LesKaribous/Karibous-2020/README.md

# Karibous-2020
Sources des projets robotique des Karibous pour l'année 2020
