LesKaribous/Karibous-2020/01 - CDRF/01 - ELECTRONIQUE/MAIN_BOARD V2/MAIN_BOARD_02_TOP.png

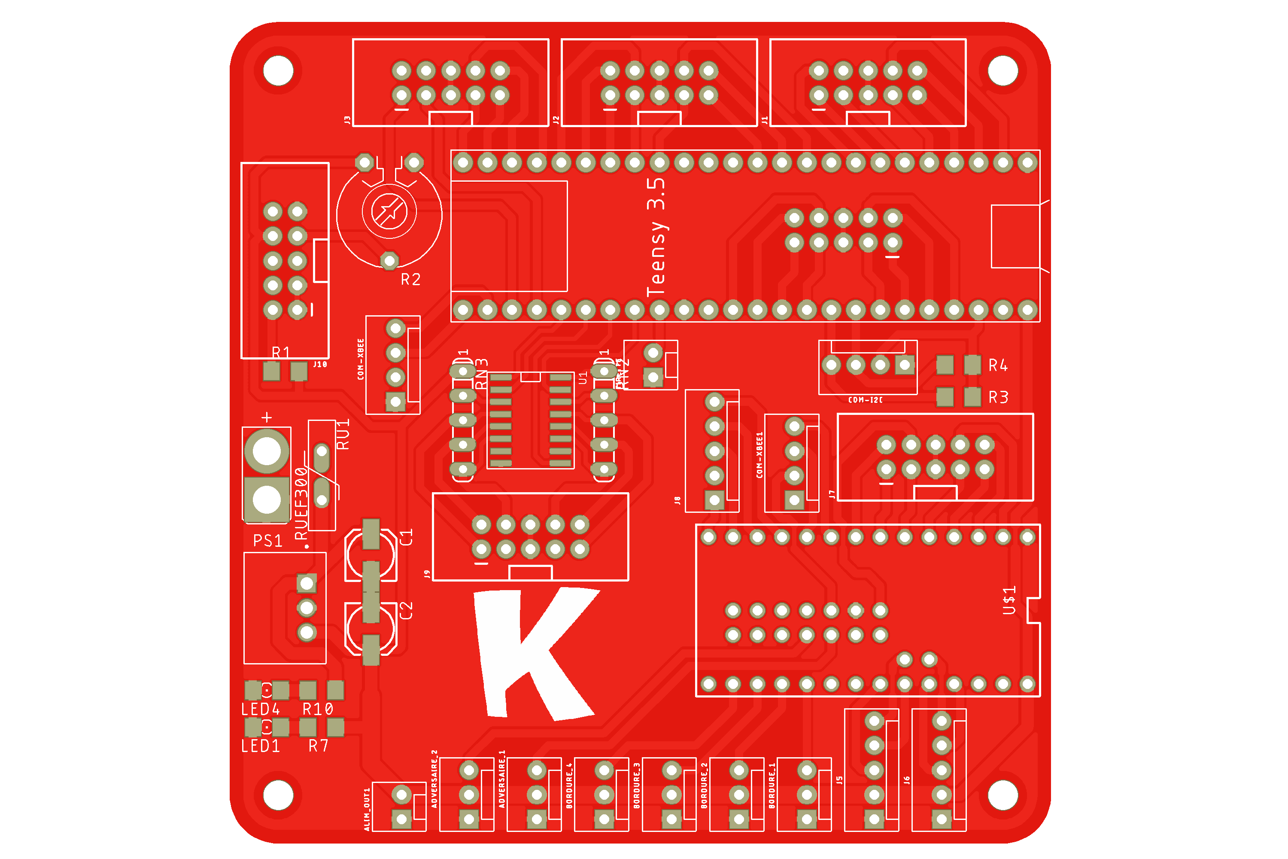
01 - CDRF/01 - ELECTRONIQUE/MAIN_BOARD V2/MAIN_BOARD_02_TOP.png
