LesKaribous/Karibous-2020/01 - CDRF/02 - MECANIQUE/01 - MAT BALISE/MAT BALISE Drawing.dxf

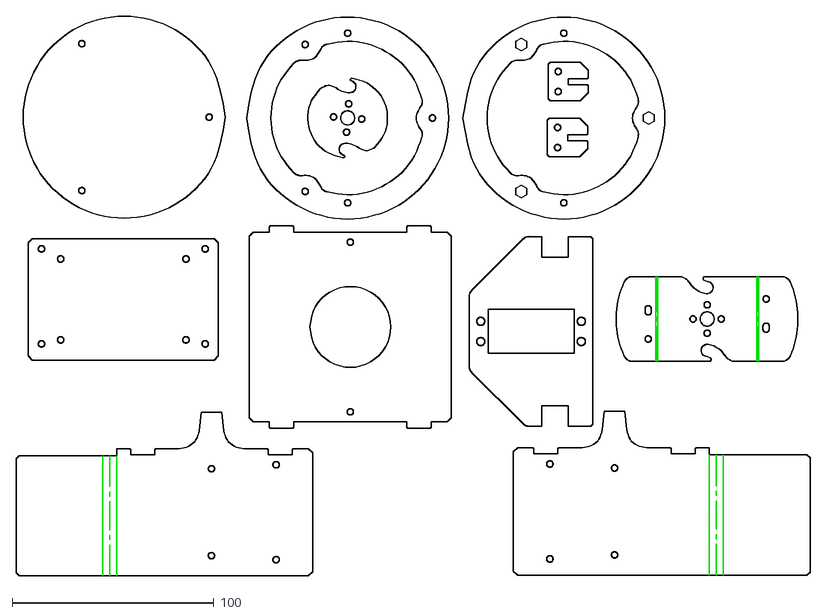
[picture p3: CAD file, 2019-10-25]
01 - CDRF/02 - MECANIQUE/01 - MAT BALISE/MAT BALISE Drawing.dxf
393.1 x 277.1
