LesKaribous/Karibous-2020/01 - CDRF/02 - MECANIQUE/02 - PNEUMATIQUE/MORS.stl

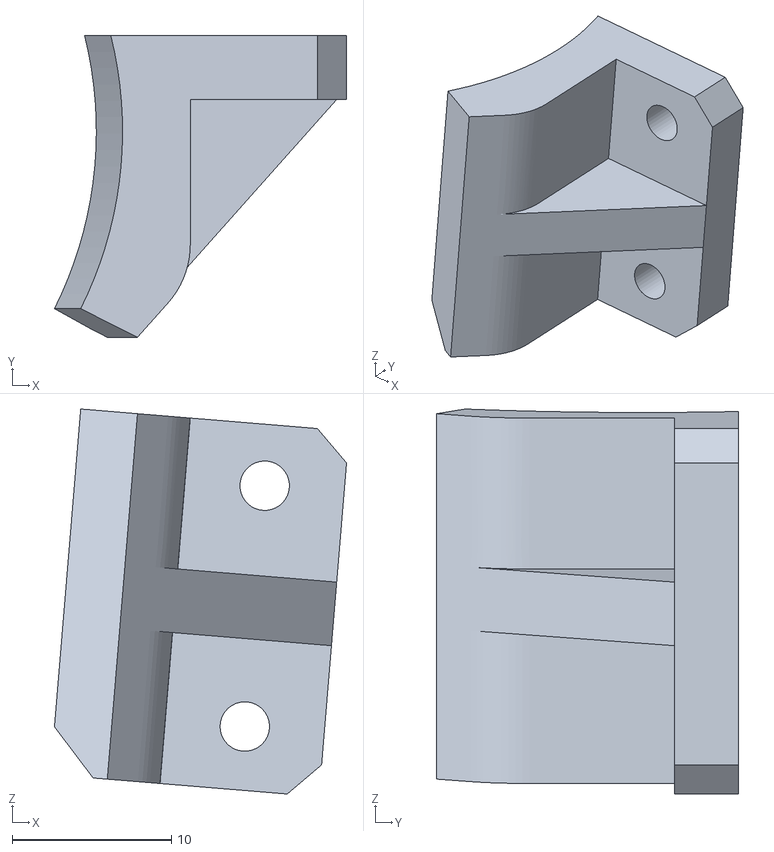
[picture p4: CAD file, 2020-03-07]
01 - CDRF/02 - MECANIQUE/02 - PNEUMATIQUE/MORS.stl
18.3 x 18.9 x 24.1
