LesKaribous/Karibous-2020/01 - CDRF/02 - MECANIQUE/01 - MAT BALISE/EQUERRE CARTER ELEC.stl

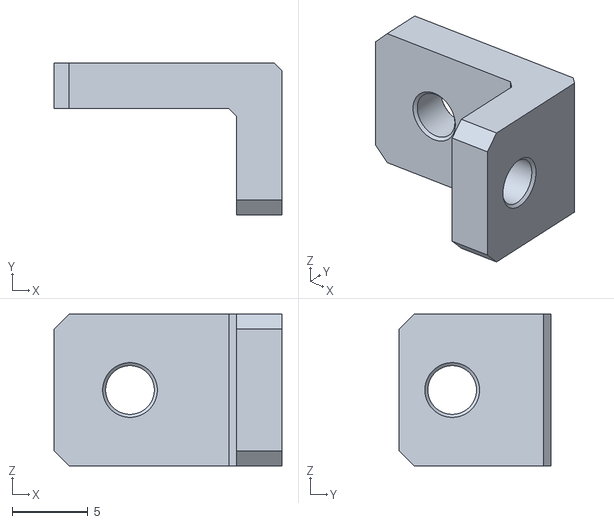
[picture p5: CAD file, 2019-10-25]
01 - CDRF/02 - MECANIQUE/01 - MAT BALISE/EQUERRE CARTER ELEC.stl
15.0 x 10.0 x 10.0
