LesKaribous/Karibous-2020/01 - CDRF/02 - MECANIQUE/02 - PNEUMATIQUE/MANCHONE_COUDE.stl

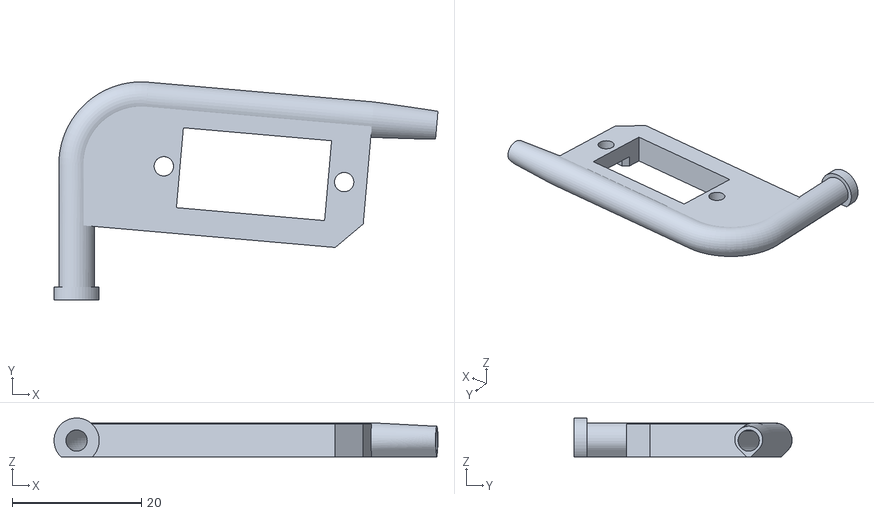
[picture p6: CAD file, 2020-03-07]
01 - CDRF/02 - MECANIQUE/02 - PNEUMATIQUE/MANCHONE_COUDE.stl
59.4 x 33.8 x 6.03
