LesKaribous/Karibous-2020/01 - CDRF/02 - MECANIQUE/02 - PNEUMATIQUE/CONNECTEUR_T.stl

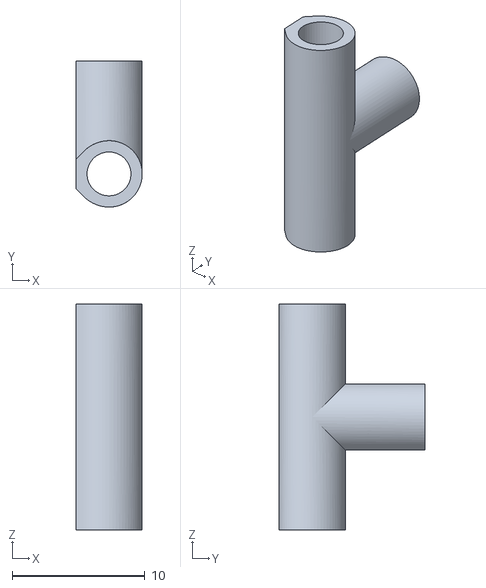
[picture p7: CAD file, 2020-01-31]
01 - CDRF/02 - MECANIQUE/02 - PNEUMATIQUE/CONNECTEUR_T.stl
5.00 x 11.0 x 17.0
