LesKaribous/Karibous-2020/01 - CDRF/02 - MECANIQUE/02 - PNEUMATIQUE/CLAMP.stl

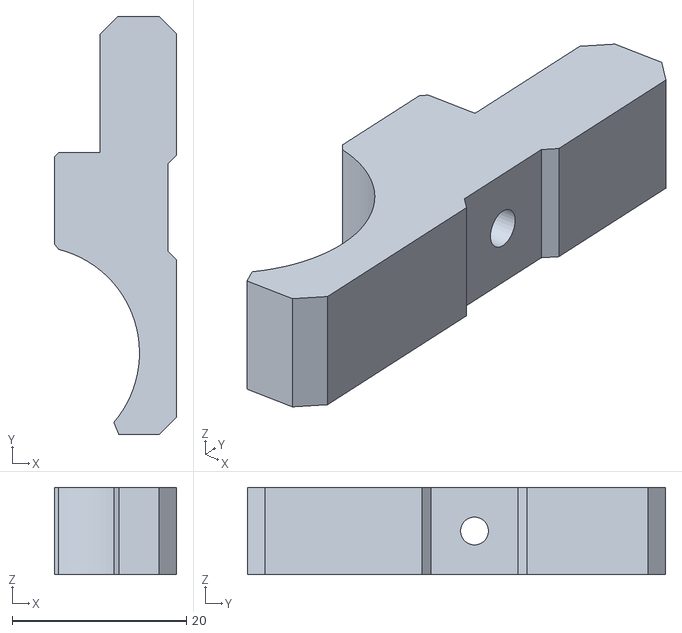
[picture p8: CAD file, 2020-01-31]
01 - CDRF/02 - MECANIQUE/02 - PNEUMATIQUE/CLAMP.stl
14.0 x 48.0 x 10.0
