LesKaribous/Karibous-2020/01 - CDRF/02 - MECANIQUE/01 - MAT BALISE/MAT BALISE Drawing.pdf

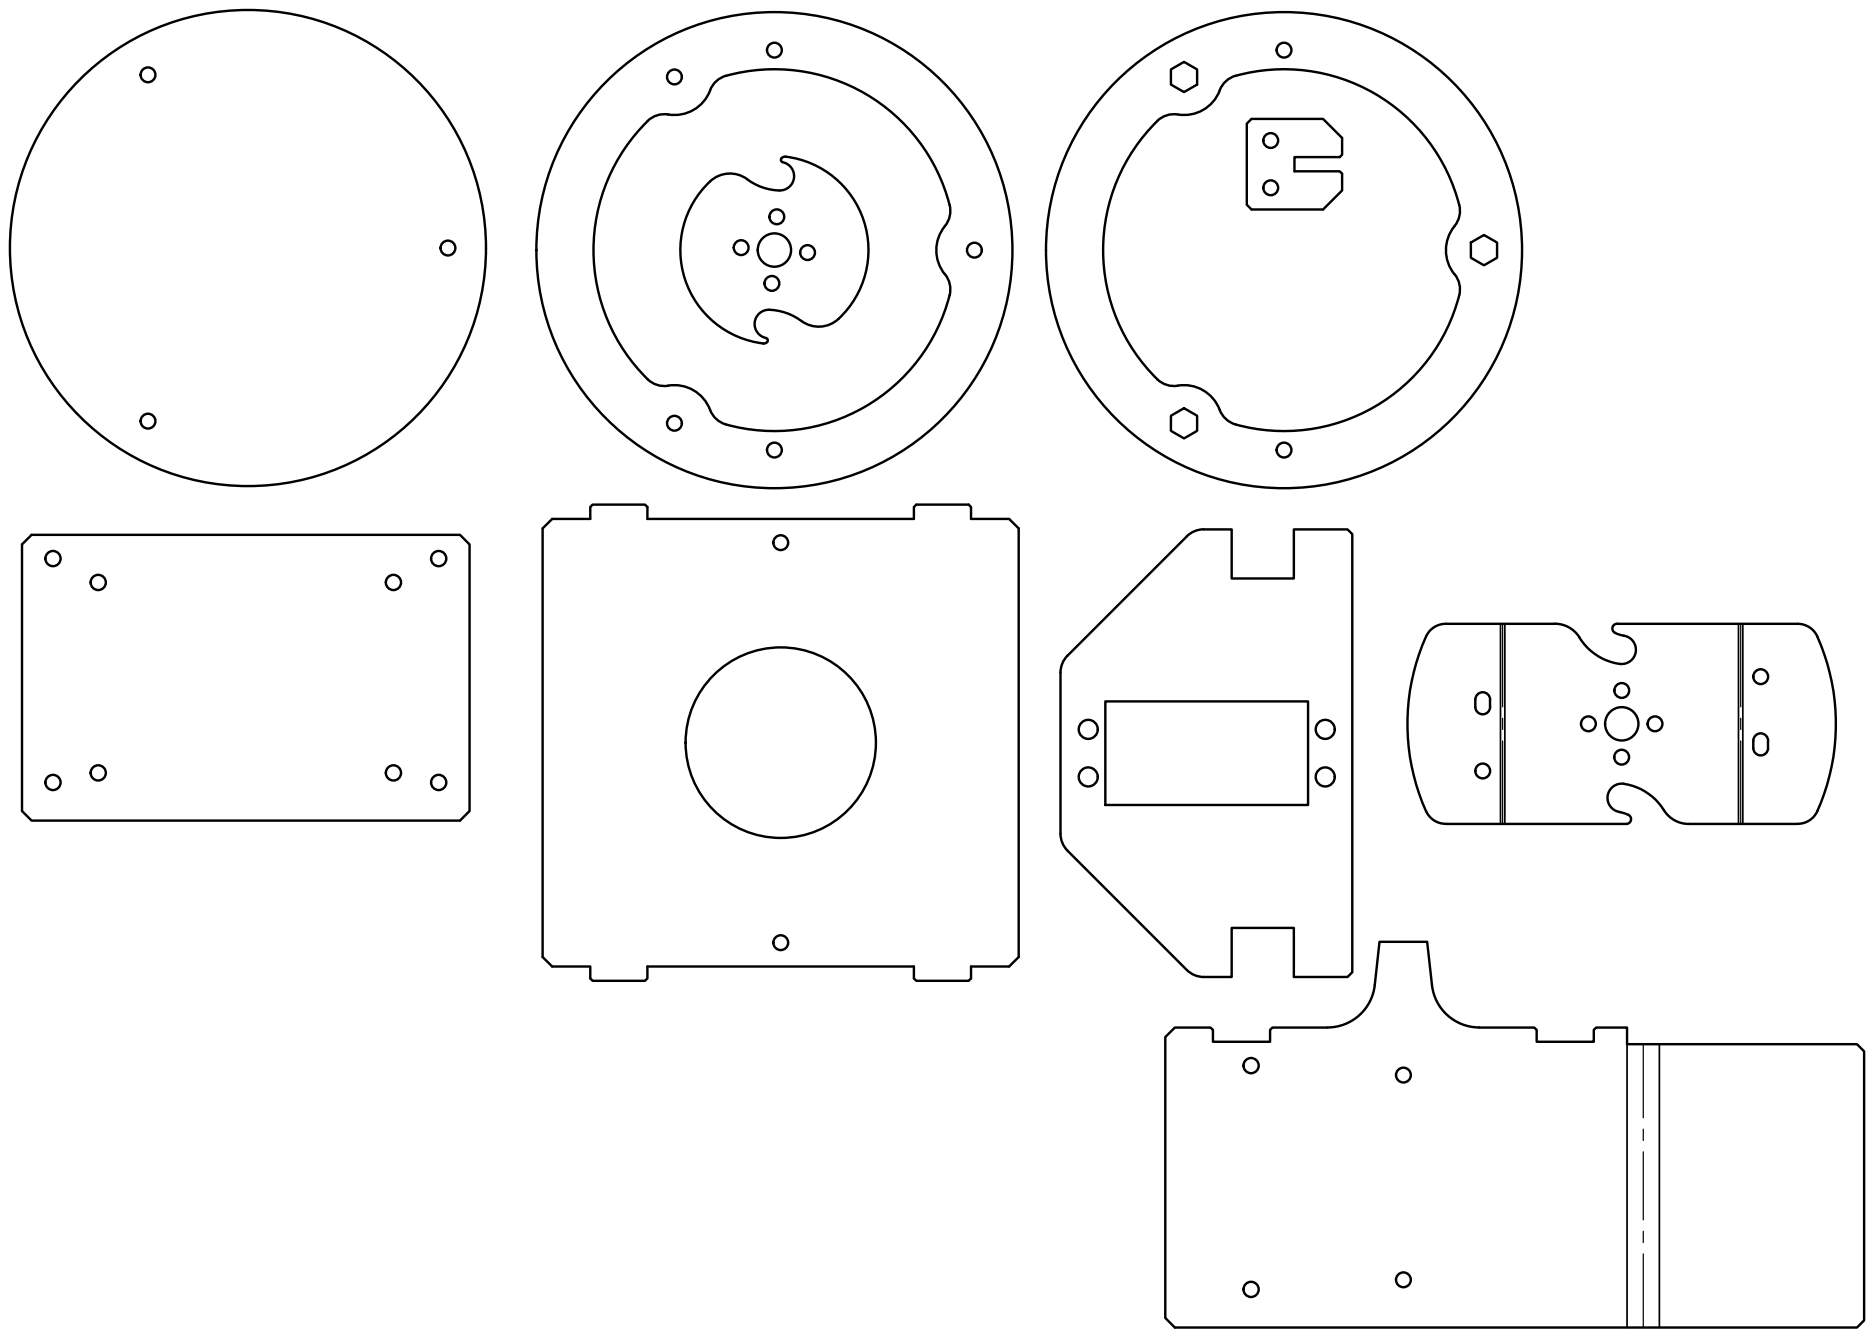
[picture p10: page 1]
