LesKaribous/Karibous-2020/01 - CDRF/01 - ELECTRONIQUE/ATTINY_SERVO_BOARD/ATTINY_SERVO_BOARD.brd

## EAGLE design 01 - CDRF/01 - ELECTRONIQUE/ATTINY_SERVO_BOARD/ATTINY_SERVO_BOARD.brd (2020-10-09)

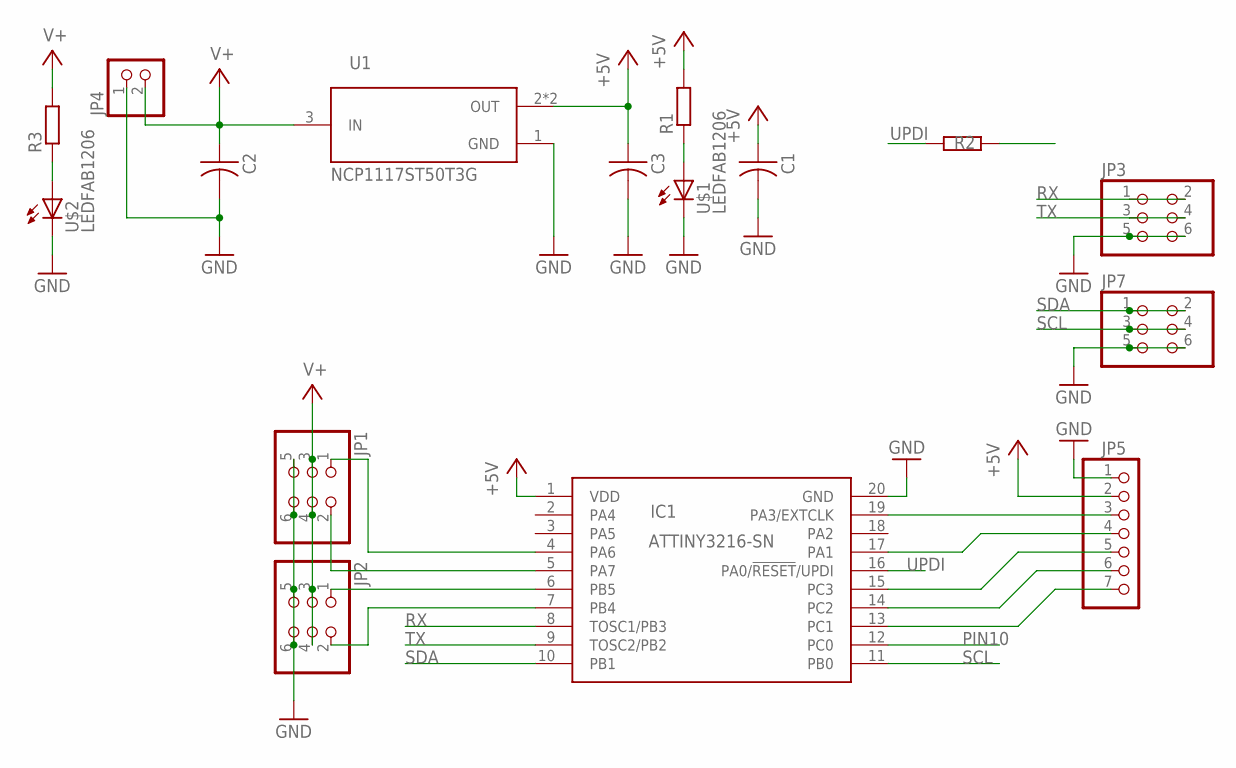
[picture p11: schematic ATTINY_SERVO_BOARD.sch]

Parts:
C1, C2, C3: CAP-US1206; C1206
IC1: ATTINY3216-SN; SOIC127P1030X265-20N
JP1, JP2, JP3, JP7: PINHD-2X03_2.54-SMD; 2X03SMD
JP4: PINHD-1X02_2.54-SMD-90°; 1X02SMD/90
JP5: PINHD-1X07_2.54-SMD-90°; 1X07SMD/90
R1, R2, R3: R-EU_R1206; R1206
U1: NCP1117ST50T3G; SOT230P700X180-4N
U$1, U$2: LEDFAB1206; LED1206FAB

Connections:
+5V: C1.1, C3.1, IC1.1 (VDD), JP5.2, R1.2, U1.2 (OUT), U1.4 (OUT)
GND: C1.2, C2.2, C3.2, IC1.20 (GND), JP1.5, JP1.6, JP2.5, JP2.6, JP3.5, JP3.6, JP4.1, JP5.1, JP7.5, JP7.6, U1.1 (GND), U$1.2 (C), U$2.2 (C)
unnamed: IC1.19 (PA3/EXTCLK), JP5.3
unnamed: R1.1, U$1.1 (A)
unnamed: IC1.7 (PB4), JP2.2
unnamed: IC1.6 (PB5), JP2.1
unnamed: IC1.5 (PA7), JP1.2
unnamed: IC1.4 (PA6), JP1.1
unnamed: R3.1, U$2.1 (A)
unnamed: IC1.17 (PA1), JP5.4
unnamed: IC1.15 (PC3), JP5.5
unnamed: IC1.14 (PC2), JP5.6
unnamed: IC1.13 (PC1), JP5.7
PIN10: IC1.12 (PC0)
RX: IC1.8 (TOSC1/PB3), JP3.1, JP3.2
SCL: IC1.11 (PB0), JP7.3, JP7.4
SDA: IC1.10 (PB1), JP7.1, JP7.2
TX: IC1.9 (TOSC2/PB2), JP3.3, JP3.4
UPDI: IC1.16 (PA0/!RESET!/UPDI), R2.2
V+: C2.1, JP1.3, JP1.4, JP2.3, JP2.4, JP4.2, R3.2, U1.3 (IN)

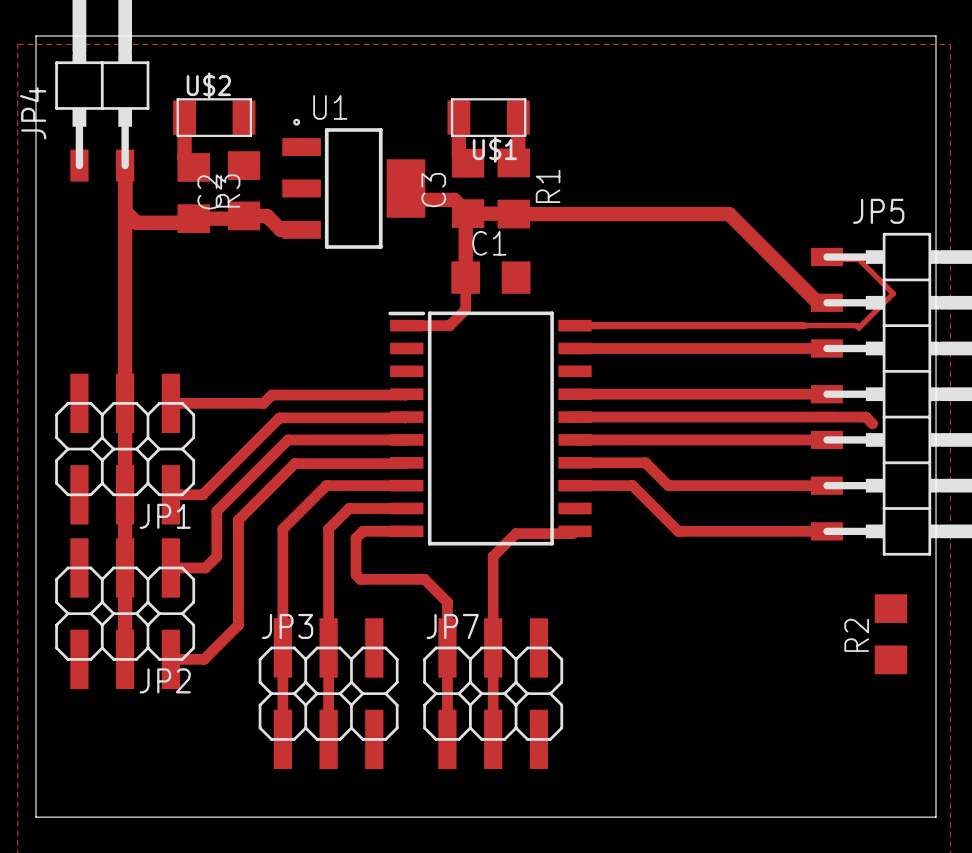
[picture p12: board ATTINY_SERVO_BOARD.brd from above]

Board: 2 copper layers, 50.0 x 43.4 mm, 16 parts (0 on the bottom side), 19 nets.
