LesKaribous/Karibous-2020/01 - CDRF/01 - ELECTRONIQUE/PCB_BALISE_328P/PCB_BALISE_328P.brd

## EAGLE design 01 - CDRF/01 - ELECTRONIQUE/PCB_BALISE_328P/PCB_BALISE_328P.brd (2020-06-26)

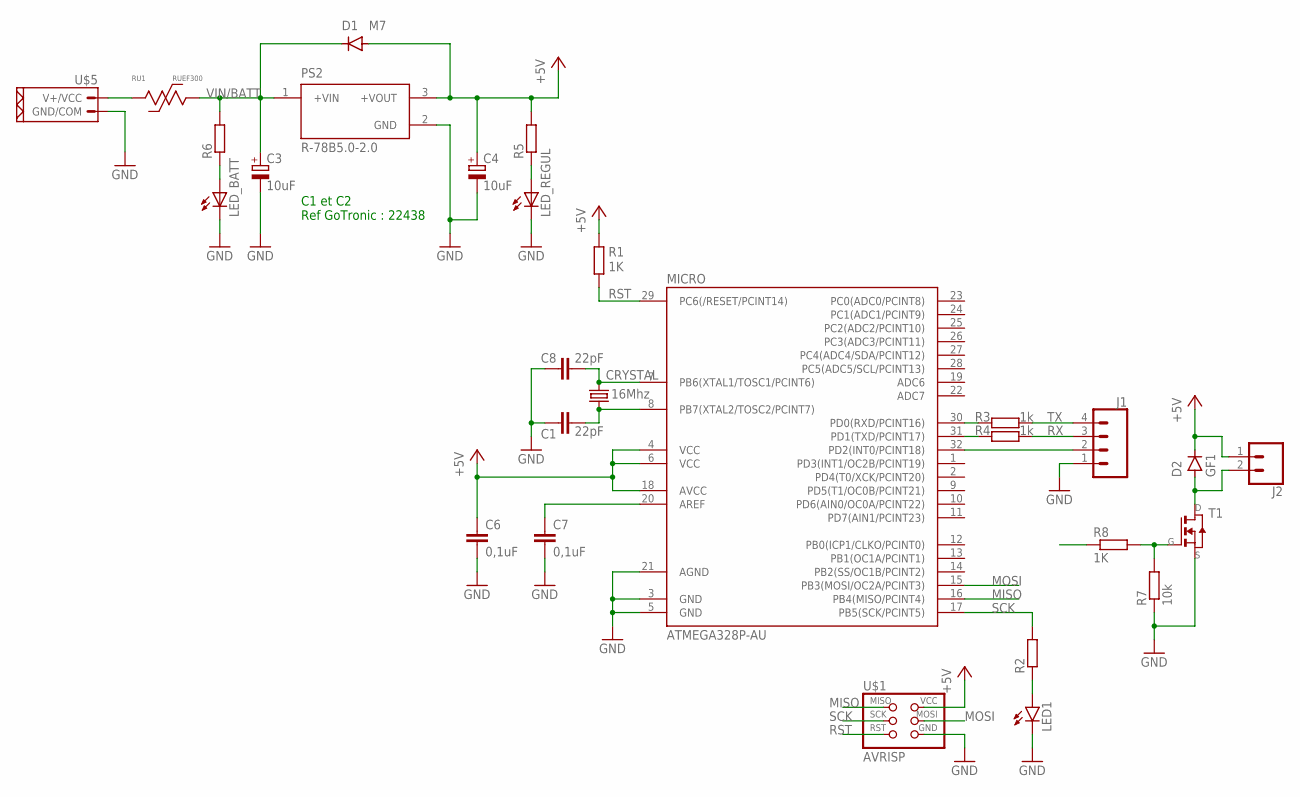
[picture p13: schematic PCB_BALISE_328P.sch]

Parts:
C1, C8: 22pF; C1206K
C3, C4: 10uF; 153CLV-0505
C6, C7: 0,1uF; C1206K
CRYSTAL: 16Mhz; CSM-7X-DU
D1: M7; MINI-SMA
D2: GF1; SMA-DO214AC
J1: CONN_04POLAR; MOLEX-1X4
J2: CONN_02POLAR; MOLEX-1X2
LED1: LEDSMT1206; 1206
LED_BATT: LED_E; LED_1206
LED_REGUL: LED_E; LED_1206
MICRO: ATMEGA328P-AU; TQFP32-08
PS2: R-78B5.0-2.0; CONV_R-78B5.0-2.0
R1, R8: 1K; R1206
R2, R5, R6: R-EU_R1206; R1206
R3, R4: 1k; R1206
R7: 10k; R1206
RU1: RUEF300
T1: NMOSFETSOT23; SOT-23
U$1: AVRISP; 2X03
U$5: CONN_02_PUIXT30; XT30_FEMALE

Connections:
+5V: C4.+, C6.1, D1.ANODE, D2.K (C), J2.1, MICRO.4 (VCC), MICRO.6 (VCC), MICRO.18 (AVCC), PS2.3 (+VOUT), R1.2, R5.2, U$1.2 (VCC)
GND: C1.1, C3.-, C4.-, C6.2, C7.2, C8.1, J1.1, LED1.C, LED_BATT.C, LED_REGUL.C, MICRO.3 (GND), MICRO.5 (GND), MICRO.21 (AGND), PS2.2 (GND), R7.1, T1.2 (S), U$1.6 (GND), U$5.P$2 (GND/COM)
MISO: MICRO.16 (PB4(MISO/PCINT4)), U$1.1 (MISO)
MOSI: MICRO.15 (PB3(MOSI/OC2A/PCINT3)), U$1.4 (MOSI)
unnamed: C7.1, MICRO.20 (AREF)
unnamed: C8.2, CRYSTAL.2, MICRO.7 (PB6(XTAL1/TOSC1/PCINT6))
unnamed: LED1.A, R2.1
unnamed: MICRO.30 (PD0(RXD/PCINT16)), R3.2
unnamed: MICRO.31 (PD1(TXD/PCINT17)), R4.2
unnamed: J1.2, MICRO.32 (PD2(INT0/PCINT18))
unnamed: LED_BATT.A, R6.1
unnamed: RU1.P$1, U$5.P$1 (V+/VCC)
unnamed: C1.2, CRYSTAL.1, MICRO.8 (PB7(XTAL2/TOSC2/PCINT7))
unnamed: LED_REGUL.A, R5.1
unnamed: D2.A, J2.2, T1.1 (D)
unnamed: R7.2, R8.2, T1.3 (G)
PUMP: R8.1
RST: MICRO.29 (PC6(/RESET/PCINT14)), R1.1, U$1.5 (RST)
RX: J1.3, R4.1
SCK: MICRO.17 (PB5(SCK/PCINT5)), R2.2, U$1.3 (SCK)
TX: J1.4, R3.1
VIN/BATT: C3.+, D1.KATHODE, PS2.1 (+VIN), R6.2, RU1.P$2

Notes on the sheet:
C1 et C2 Ref GoTronic : 22438

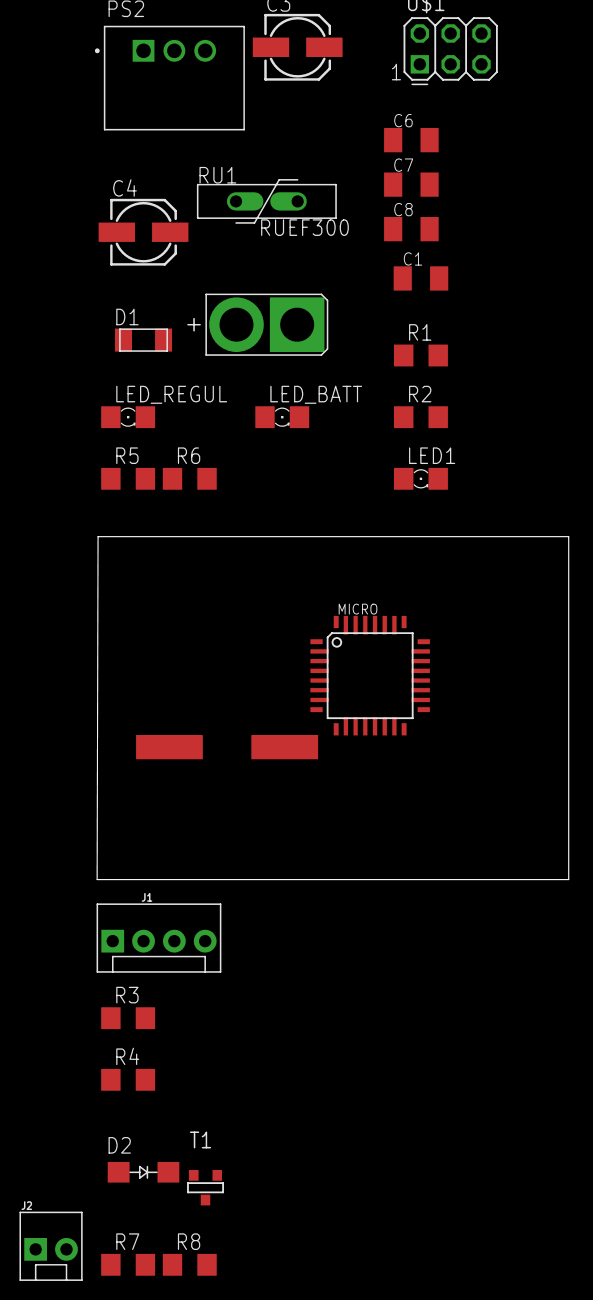
[picture p14: board PCB_BALISE_328P.brd from above]

Board: 2 copper layers, 38.9 x 28.3 mm, 28 parts (0 on the bottom side), 21 nets.
