LesKaribous/Karibous-2020/01 - CDRF/01 - ELECTRONIQUE/CAPTEUR_HALL_V2/AdaptSensor.brd

## EAGLE design 01 - CDRF/01 - ELECTRONIQUE/CAPTEUR_HALL_V2/AdaptSensor.brd (2020-06-22)

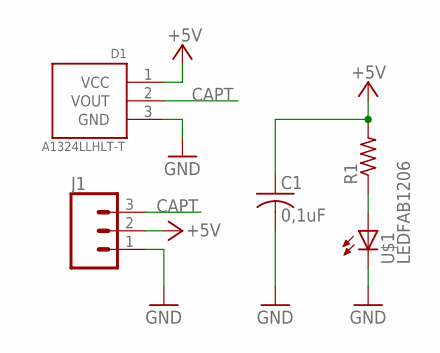
[picture p15: schematic AdaptSensor.sch]

Parts:
C1: 0,1uF; C1206FAB
D1: A1324LLHLT-T; SOT190P290X100-3N
J1: CONN_03POLAR; MOLEX-1X3
R1: RES-US1206FAB; R1206FAB
U$1: LEDFAB1206; LED1206FAB

Connections:
+5V: C1.1, D1.1 (VCC), J1.2, R1.2
CAPT: D1.2 (VOUT), J1.3
GND: C1.2, D1.3 (GND), J1.1, U$1.2 (C)
unnamed: R1.1, U$1.1 (A)

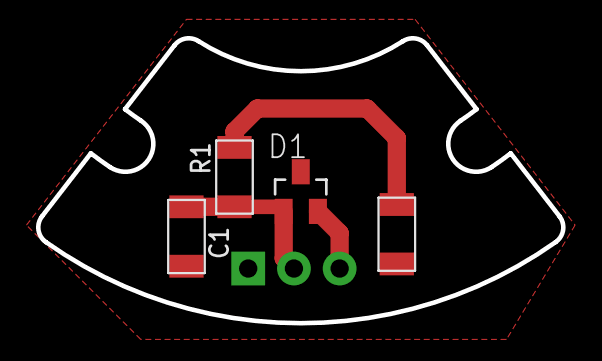
[picture p16: board AdaptSensor.brd from above]

Board: 2 copper layers, 29.2 x 15.8 mm, 5 parts (1 on the bottom side), 4 nets.
