LesKaribous/Karibous-2020/01 - CDRF/01 - ELECTRONIQUE/PCB_MOTEUR V2/PCB_MOTEUR_V0_2b.brd

## EAGLE design 01 - CDRF/01 - ELECTRONIQUE/PCB_MOTEUR V2/PCB_MOTEUR_V0_2b.brd (2020-05-23)

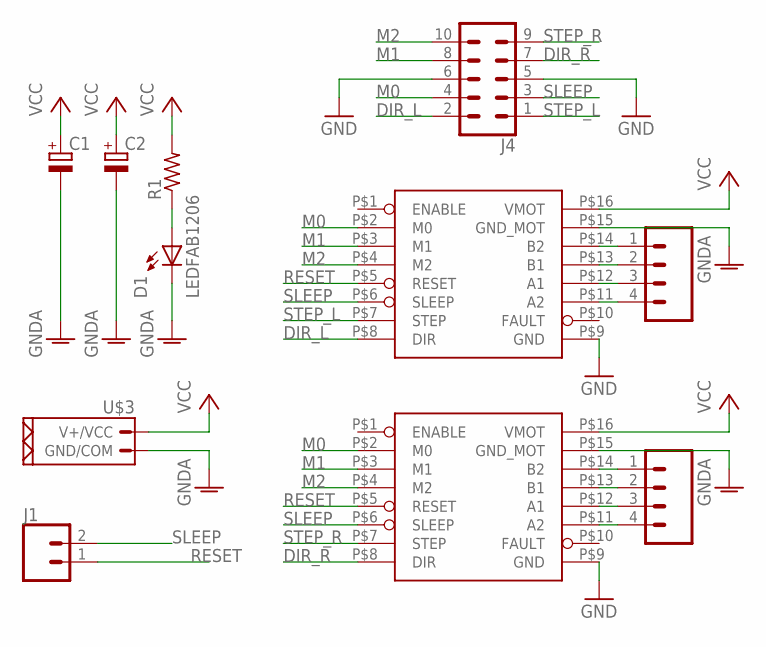
[picture p17: schematic PCB_MOTEUR_V0_2b.sch]

Parts:
C1, C2: CPOL-EUE3.5-8; E3,5-8
D1: LEDFAB1206; LED1206FAB
J1: CONN_02; 1X02
J3, J5: CONN_04POLAR; MOLEX-1X4
J4: CONN_05X2SHD; 2X5-SHROUDED
R1: RES-US1206FAB; R1206FAB
U$1, U$2: DRV8825; DRIVER_CARRIER_POLOLU_16
U$3: CONN_02_PUIXT30; XT30_FEMALE

Connections:
DIR_L: J4.2, U$1.P$8 (DIR)
DIR_R: J4.7, U$2.P$8 (DIR)
GND: J4.5, J4.6, U$1.P$9 (GND), U$2.P$9 (GND)
GNDA: C1.-, C2.-, D1.2 (C), U$1.P$15 (GND_MOT), U$2.P$15 (GND_MOT), U$3.P$2 (GND/COM)
M0: J4.4, U$1.P$2 (M0), U$2.P$2 (M0)
M1: J4.8, U$1.P$3 (M1), U$2.P$3 (M1)
M2: J4.10, U$1.P$4 (M2), U$2.P$4 (M2)
unnamed: J3.1, U$1.P$14 (B2)
unnamed: J3.2, U$1.P$13 (B1)
unnamed: J3.3, U$1.P$12 (A1)
unnamed: J3.4, U$1.P$11 (A2)
unnamed: D1.1 (A), R1.1
unnamed: J5.1, U$2.P$14 (B2)
unnamed: J5.2, U$2.P$13 (B1)
unnamed: J5.3, U$2.P$12 (A1)
unnamed: J5.4, U$2.P$11 (A2)
RESET: J1.1, U$1.P$5 (RESET), U$2.P$5 (RESET)
SLEEP: J1.2, J4.3, U$1.P$6 (SLEEP), U$2.P$6 (SLEEP)
STEP_L: J4.1, U$1.P$7 (STEP)
STEP_R: J4.9, U$2.P$7 (STEP)
VCC: C1.+, C2.+, R1.2, U$1.P$16 (VMOT), U$2.P$16 (VMOT), U$3.P$1 (V+/VCC)

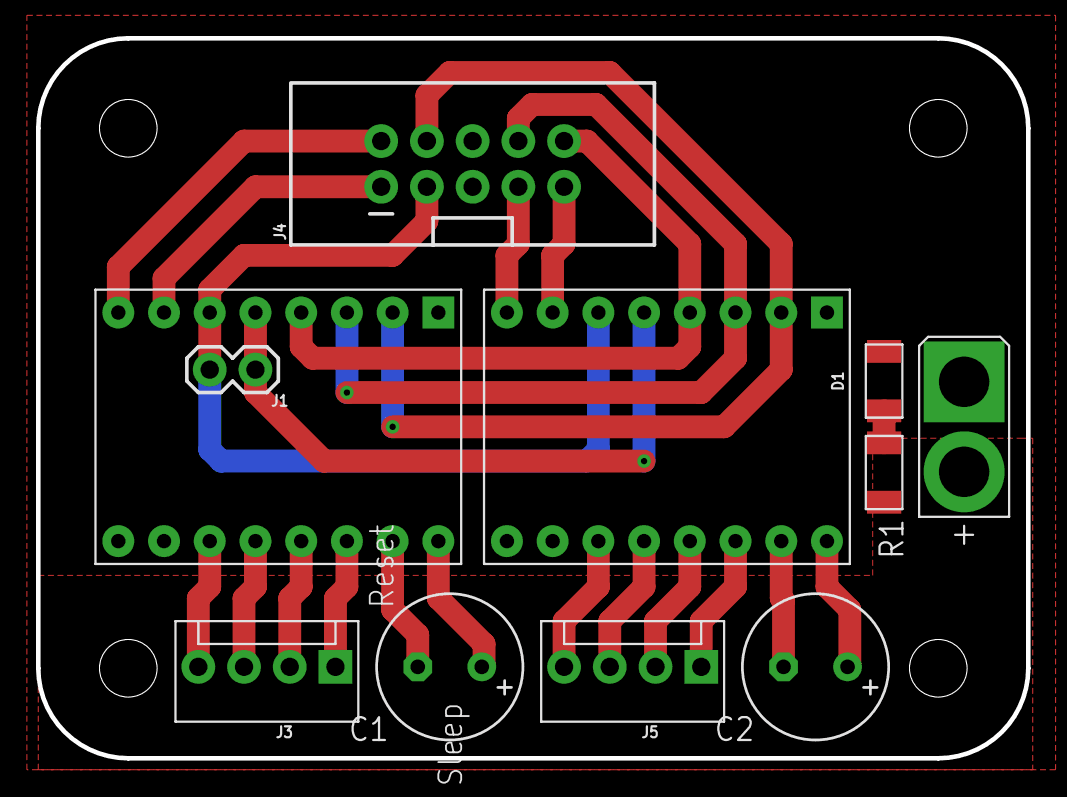
[picture p18: board PCB_MOTEUR_V0_2b.brd from above]

Board: 2 copper layers, 55.0 x 40.0 mm, 11 parts (0 on the bottom side), 21 nets.
