LesKaribous/Karibous-2020/01 - CDRF/01 - ELECTRONIQUE/MAIN_BOARD V2/MAIN_BOARD_02.brd

## EAGLE design 01 - CDRF/01 - ELECTRONIQUE/MAIN_BOARD V2/MAIN_BOARD_02.brd (2020-05-23)

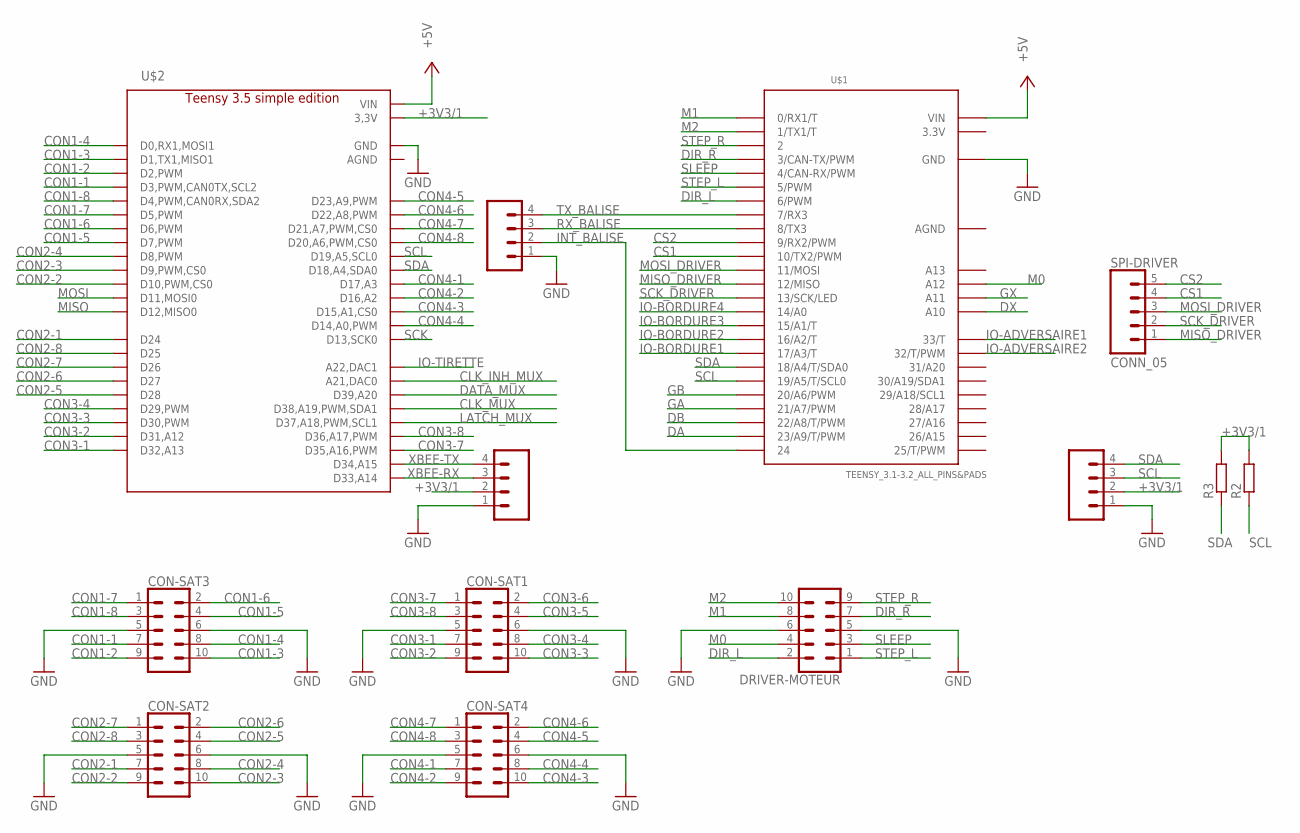
[picture p19: schematic MAIN_BOARD_02.sch, sheet 1]

Parts:
COM-BALISE: CONN_04POLAR; MOLEX-1X4
COM-I2C: CONN_04POLAR; MOLEX-1X4
COM-XBEE: CONN_04POLAR; MOLEX-1X4
CON-SAT1, CON-SAT2, CON-SAT3, CON-SAT4: CONN_05X2SHD; 2X5-SHROUDED
DRIVER-MOTEUR: CONN_05X2SHD; 2X5-SHROUDED
R2, R3: R-EU_R1206; R1206
SPI-DRIVER: CONN_05; MOLEX-1X5
U$1: TEENSY_3.1-3.2_ALL_PINS&PADS; TEENSY_3.0-3.2_ALL_PINS_&_PADS
U$2: TEENSY_3.5; TEENSY_3.5_LIGHT

Connections:
3.3V: U$1.3.3V, U$1.3.3V2 (3.3V)
+3V3/1: COM-I2C.2, COM-XBEE.2, R2.2, R3.2, U$2.P$15 (3,3V), U$2.P$46 (3,3V)
+5V: U$1.VIN, U$2.P$48 (VIN); also elsewhere on the board
AGND: U$1.AGND
CLK_INH_MUX: U$2.P$32 (A21,DAC0); also elsewhere on the board
CLK_MUX: U$2.P$30 (D38,A19,PWM,SDA1); also elsewhere on the board
CON1-1: CON-SAT3.7, U$2.P$5 (D3,PWM,CAN0TX,SCL2)
CON1-2: CON-SAT3.9, U$2.P$4 (D2,PWM)
CON1-3: CON-SAT3.10, U$2.P$3 (D1,TX1,MISO1)
CON1-4: CON-SAT3.8, U$2.P$2 (D0,RX1,MOSI1)
CON1-5: CON-SAT3.4, U$2.P$9 (D7,PWM)
CON1-6: CON-SAT3.2, U$2.P$8 (D6,PWM)
CON1-7: CON-SAT3.1, U$2.P$7 (D5,PWM)
CON1-8: CON-SAT3.3, U$2.P$6 (D4,PWM,CAN0RX,SDA2)
CON2-1: CON-SAT2.7, U$2.P$16 (D24)
CON2-2: CON-SAT2.9, U$2.P$12 (D10,PWM,CS0)
CON2-3: CON-SAT2.10, U$2.P$11 (D9,PWM,CS0)
CON2-4: CON-SAT2.8, U$2.P$10 (D8,PWM)
CON2-5: CON-SAT2.4, U$2.P$20 (D28)
CON2-6: CON-SAT2.2, U$2.P$19 (D27)
CON2-7: CON-SAT2.1, U$2.P$18 (D26)
CON2-8: CON-SAT2.3, U$2.P$17 (D25)
CON3-1: CON-SAT1.7, U$2.P$24 (D32,A13)
CON3-2: CON-SAT1.9, U$2.P$23 (D31,A12)
CON3-3: CON-SAT1.10, U$2.P$22 (D30,PWM)
CON3-4: CON-SAT1.8, U$2.P$21 (D29,PWM)
CON3-5: CON-SAT1.4
CON3-6: CON-SAT1.2
CON3-7: CON-SAT1.1, U$2.P$27 (D35,A16,PWM)
CON3-8: CON-SAT1.3, U$2.P$28 (D36,A17,PWM)
CON4-1: CON-SAT4.7, U$2.P$39 (D17,A3)
CON4-2: CON-SAT4.9, U$2.P$38 (D16,A2)
CON4-3: CON-SAT4.10, U$2.P$37 (D15,A1,CS0)
CON4-4: CON-SAT4.8, U$2.P$36 (D14,A0,PWM)
CON4-5: CON-SAT4.4, U$2.P$45 (D23,A9,PWM)
CON4-6: CON-SAT4.2, U$2.P$44 (D22,A8,PWM)
CON4-7: CON-SAT4.1, U$2.P$43 (D21,A7,PWM,CS0)
CON4-8: CON-SAT4.3, U$2.P$42 (D20,A6,PWM,CS0)
CS1: SPI-DRIVER.4, U$1.10 (10/TX2/PWM)
CS2: SPI-DRIVER.5, U$1.9 (9/RX2/PWM)
DA: U$1.23/A9 (23/A9/T/PWM); also elsewhere on the board
DATA_MUX: U$2.P$31 (D39,A20); also elsewhere on the board
DB: U$1.22/A8 (22/A8/T/PWM); also elsewhere on the board
DIR_L: DRIVER-MOTEUR.2, U$1.6 (6/PWM)
DIR_R: DRIVER-MOTEUR.7, U$1.3 (3/CAN-TX/PWM)
DX: U$1.A10; also elsewhere on the board
GA: U$1.21/A7 (21/A7/PWM); also elsewhere on the board
GB: U$1.20/A6 (20/A6/PWM); also elsewhere on the board
GND: COM-BALISE.1, COM-I2C.1, COM-XBEE.1, CON-SAT1.5, CON-SAT1.6, CON-SAT2.5, CON-SAT2.6, CON-SAT3.5, CON-SAT3.6, CON-SAT4.5, CON-SAT4.6, DRIVER-MOTEUR.5, DRIVER-MOTEUR.6, U$1.GND, U$1.GND2 (GND), U$2.GND, U$2.P$34 (GND); also elsewhere on the board
GX: U$1.A11; also elsewhere on the board
INT_BALISE: COM-BALISE.2, U$1.24
IO-ADVERSAIRE1: U$1.33 (33/T); also elsewhere on the board
IO-ADVERSAIRE2: U$1.32 (32/T/PWM); also elsewhere on the board
IO-BORDURE1: U$1.17/A3 (17/A3/T); also elsewhere on the board
IO-BORDURE2: U$1.16/A2 (16/A2/T); also elsewhere on the board
IO-BORDURE3: U$1.15/A1 (15/A1/T); also elsewhere on the board
IO-BORDURE4: U$1.14/A0; also elsewhere on the board
IO-TIRETTE: U$2.P$33 (A22,DAC1); also elsewhere on the board
LATCH_MUX: U$2.P$29 (D37,A18,PWM,SCL1); also elsewhere on the board
M0: DRIVER-MOTEUR.4, U$1.A12
M1: DRIVER-MOTEUR.8, U$1.0 (0/RX1/T)
M2: DRIVER-MOTEUR.10, U$1.1 (1/TX1/T)
MISO: U$2.P$14 (D12,MISO0); also elsewhere on the board
MISO_DRIVER: SPI-DRIVER.1, U$1.12 (12/MISO)
MOSI: U$2.P$13 (D11,MOSI0); also elsewhere on the board
MOSI_DRIVER: SPI-DRIVER.3, U$1.11 (11/MOSI)
RX_BALISE: COM-BALISE.3, U$1.8 (8/TX3)
SCK: U$2.P$35 (D13,SCK0); also elsewhere on the board
SCK_DRIVER: SPI-DRIVER.2, U$1.13 (13/SCK/LED)
SCL: COM-I2C.3, R2.1, U$1.19/A5 (19/A5/T/SCL0), U$2.P$41 (D19,A5,SCL0)
SDA: COM-I2C.4, R3.1, U$1.18/A4 (18/A4/T/SDA0), U$2.P$40 (D18,A4,SDA0)
SLEEP: DRIVER-MOTEUR.3, U$1.4 (4/CAN-RX/PWM)
STEP_L: DRIVER-MOTEUR.1, U$1.5 (5/PWM)
STEP_R: DRIVER-MOTEUR.9, U$1.2
TX_BALISE: COM-BALISE.4, U$1.7 (7/RX3)
XBEE-RX: COM-XBEE.3, U$2.P$25 (D33,A14)
XBEE-TX: COM-XBEE.4, U$2.P$26 (D34,A15)

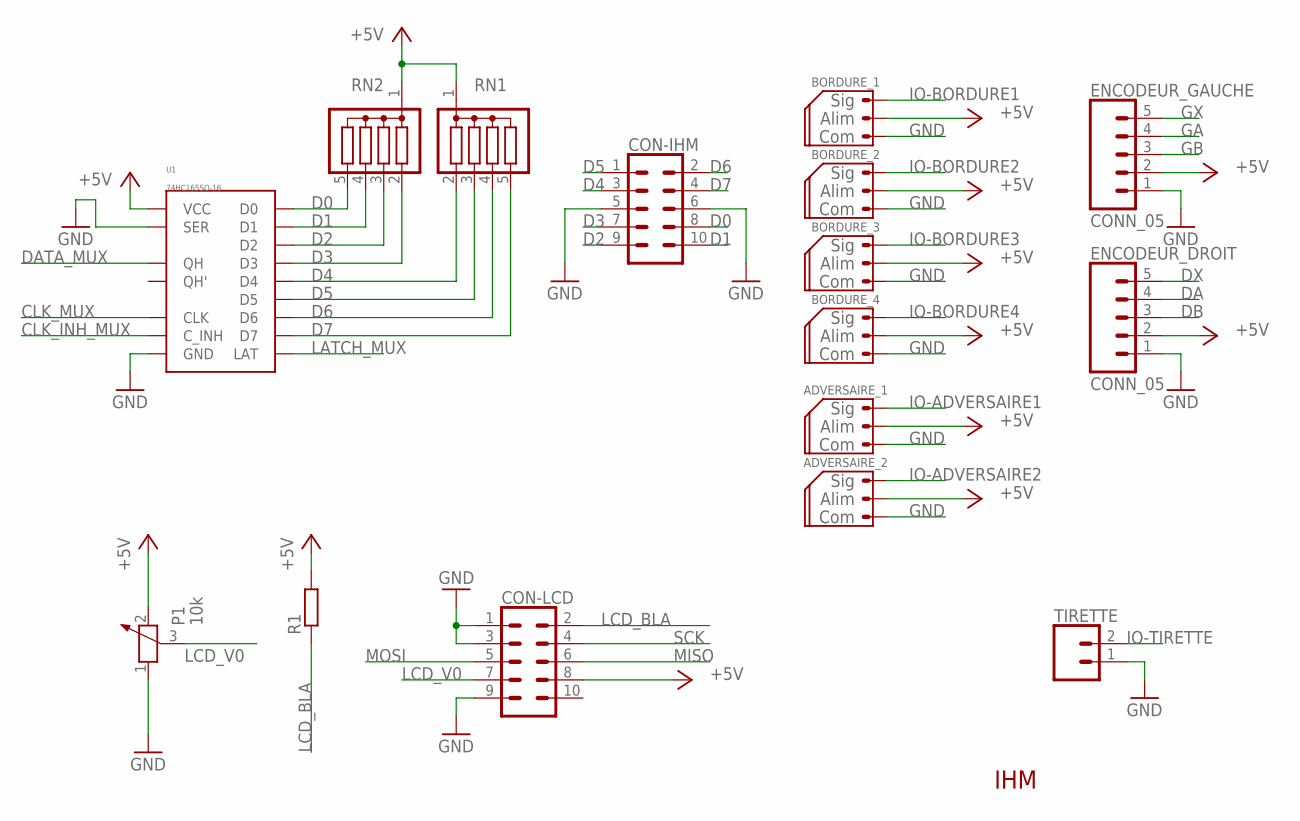
[picture p20: schematic MAIN_BOARD_02.sch, sheet 2]

Parts:
ADVERSAIRE_1, ADVERSAIRE_2: CONN_03_SERVO; MOLEX-1X3
BORDURE_1, BORDURE_2, BORDURE_3, BORDURE_4: CONN_03_SERVO; MOLEX-1X3
CON-IHM: CONN_05X2SHD; 2X5-SHROUDED
CON-LCD: CONN_05X2SHD; 2X5-SHROUDED
ENCODEUR_DROIT: CONN_05; MOLEX-1X5
ENCODEUR_GAUCHE: CONN_05; MOLEX-1X5
P1: 10k; PT-10
R1: R-EU_R1206; R1206
RN1, RN2: G04R; SIL5
TIRETTE: CONN_02POLAR; MOLEX-1X2
U1: 74HC165SO-16; SO-16
U$3: LOGO_K; LOGO_KARIBOU

Connections:
+5V: ADVERSAIRE_1.2, ADVERSAIRE_2.2, BORDURE_1.2, BORDURE_2.2, BORDURE_3.2, BORDURE_4.2, CON-LCD.8, ENCODEUR_DROIT.2, ENCODEUR_GAUCHE.2, P1.2, R1.2, RN1.1, RN2.1, U1.16 (VCC); also elsewhere on the board
CLK_INH_MUX: U1.15 (C_INH); also elsewhere on the board
CLK_MUX: U1.2 (CLK); also elsewhere on the board
D0: CON-IHM.8, RN2.5, U1.11 (D0)
D1: CON-IHM.10, RN2.4, U1.12 (D1)
D2: CON-IHM.9, RN2.3, U1.13 (D2)
D3: CON-IHM.7, RN2.2, U1.14 (D3)
D4: CON-IHM.3, RN1.2, U1.3 (D4)
D5: CON-IHM.1, RN1.3, U1.4 (D5)
D6: CON-IHM.2, RN1.4, U1.5 (D6)
D7: CON-IHM.4, RN1.5, U1.6 (D7)
DA: ENCODEUR_DROIT.4; also elsewhere on the board
DATA_MUX: U1.9 (QH); also elsewhere on the board
DB: ENCODEUR_DROIT.3; also elsewhere on the board
DX: ENCODEUR_DROIT.5; also elsewhere on the board
GA: ENCODEUR_GAUCHE.4; also elsewhere on the board
GB: ENCODEUR_GAUCHE.3; also elsewhere on the board
GND: ADVERSAIRE_1.1, ADVERSAIRE_2.1, BORDURE_1.1, BORDURE_2.1, BORDURE_3.1, BORDURE_4.1, CON-IHM.5, CON-IHM.6, CON-LCD.1, CON-LCD.3, CON-LCD.9, ENCODEUR_DROIT.1, ENCODEUR_GAUCHE.1, P1.1, TIRETTE.1, U1.8 (GND), U1.10 (SER); also elsewhere on the board
GX: ENCODEUR_GAUCHE.5; also elsewhere on the board
IO-ADVERSAIRE1: ADVERSAIRE_1.3; also elsewhere on the board
IO-ADVERSAIRE2: ADVERSAIRE_2.3; also elsewhere on the board
IO-BORDURE1: BORDURE_1.3; also elsewhere on the board
IO-BORDURE2: BORDURE_2.3; also elsewhere on the board
IO-BORDURE3: BORDURE_3.3; also elsewhere on the board
IO-BORDURE4: BORDURE_4.3; also elsewhere on the board
IO-TIRETTE: TIRETTE.2; also elsewhere on the board
LATCH_MUX: U1.1 (LAT); also elsewhere on the board
LCD_BLA: CON-LCD.2, R1.1
LCD_V0: CON-LCD.7, P1.3
MISO: CON-LCD.6; also elsewhere on the board
MOSI: CON-LCD.5; also elsewhere on the board
SCK: CON-LCD.4; also elsewhere on the board

Notes on the sheet:
IHM

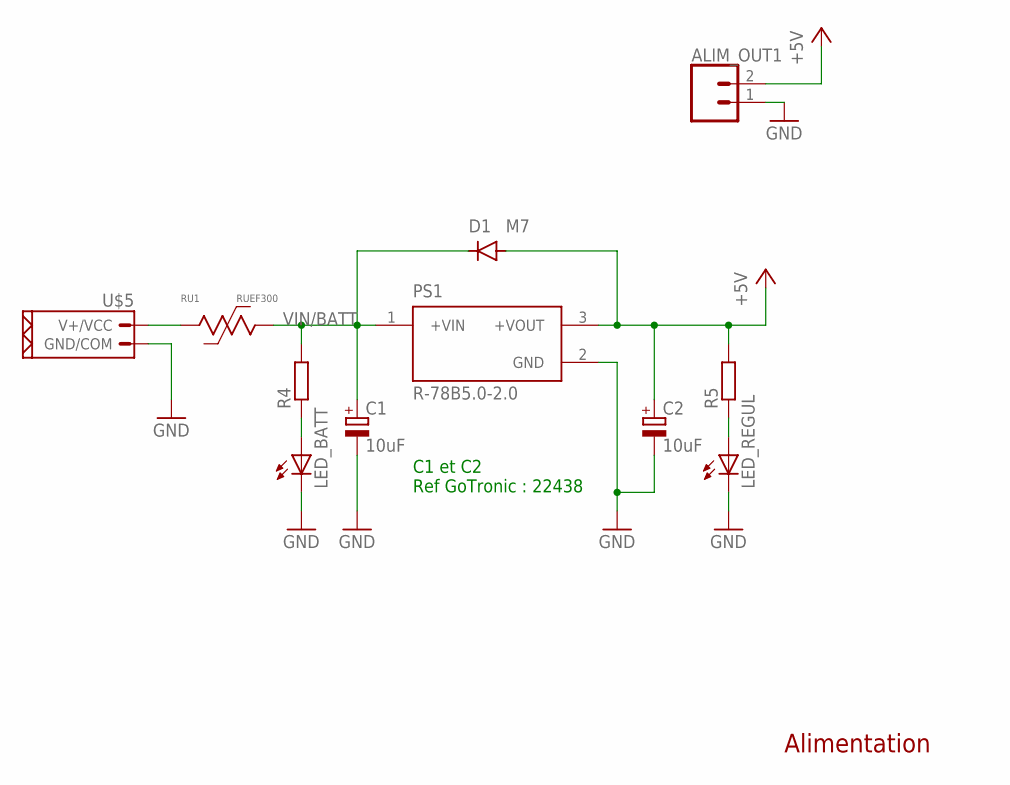
[picture p21: schematic MAIN_BOARD_02.sch, sheet 3]

Parts:
ALIM_OUT1: CONN_02POLAR; MOLEX-1X2
C1, C2: 10uF; 153CLV-0505
D1: M7; MINI-SMA
LED_BATT: LED_E; LED_1206
LED_REGUL: LED_E; LED_1206
PS1: R-78B5.0-2.0; CONV_R-78B5.0-2.0
R4, R5: R-EU_R1206; R1206
RU1: RUEF300
U$4: LOGO_K; LOGO_KARIBOU
U$5: CONN_02_PUIXT30; XT30_FEMALE

Connections:
+5V: ALIM_OUT1.2, C2.+, D1.ANODE, PS1.3 (+VOUT), R5.2; also elsewhere on the board
GND: ALIM_OUT1.1, C1.-, C2.-, LED_BATT.C, LED_REGUL.C, PS1.2 (GND), U$5.P$2 (GND/COM); also elsewhere on the board
unnamed: LED_REGUL.A, R5.1
unnamed: LED_BATT.A, R4.1
unnamed: RU1.P$1, U$5.P$1 (V+/VCC)
VIN/BATT: C1.+, D1.KATHODE, PS1.1 (+VIN), R4.2, RU1.P$2

Notes on the sheet:
Alimentation
C1 et C2 Ref GoTronic : 22438

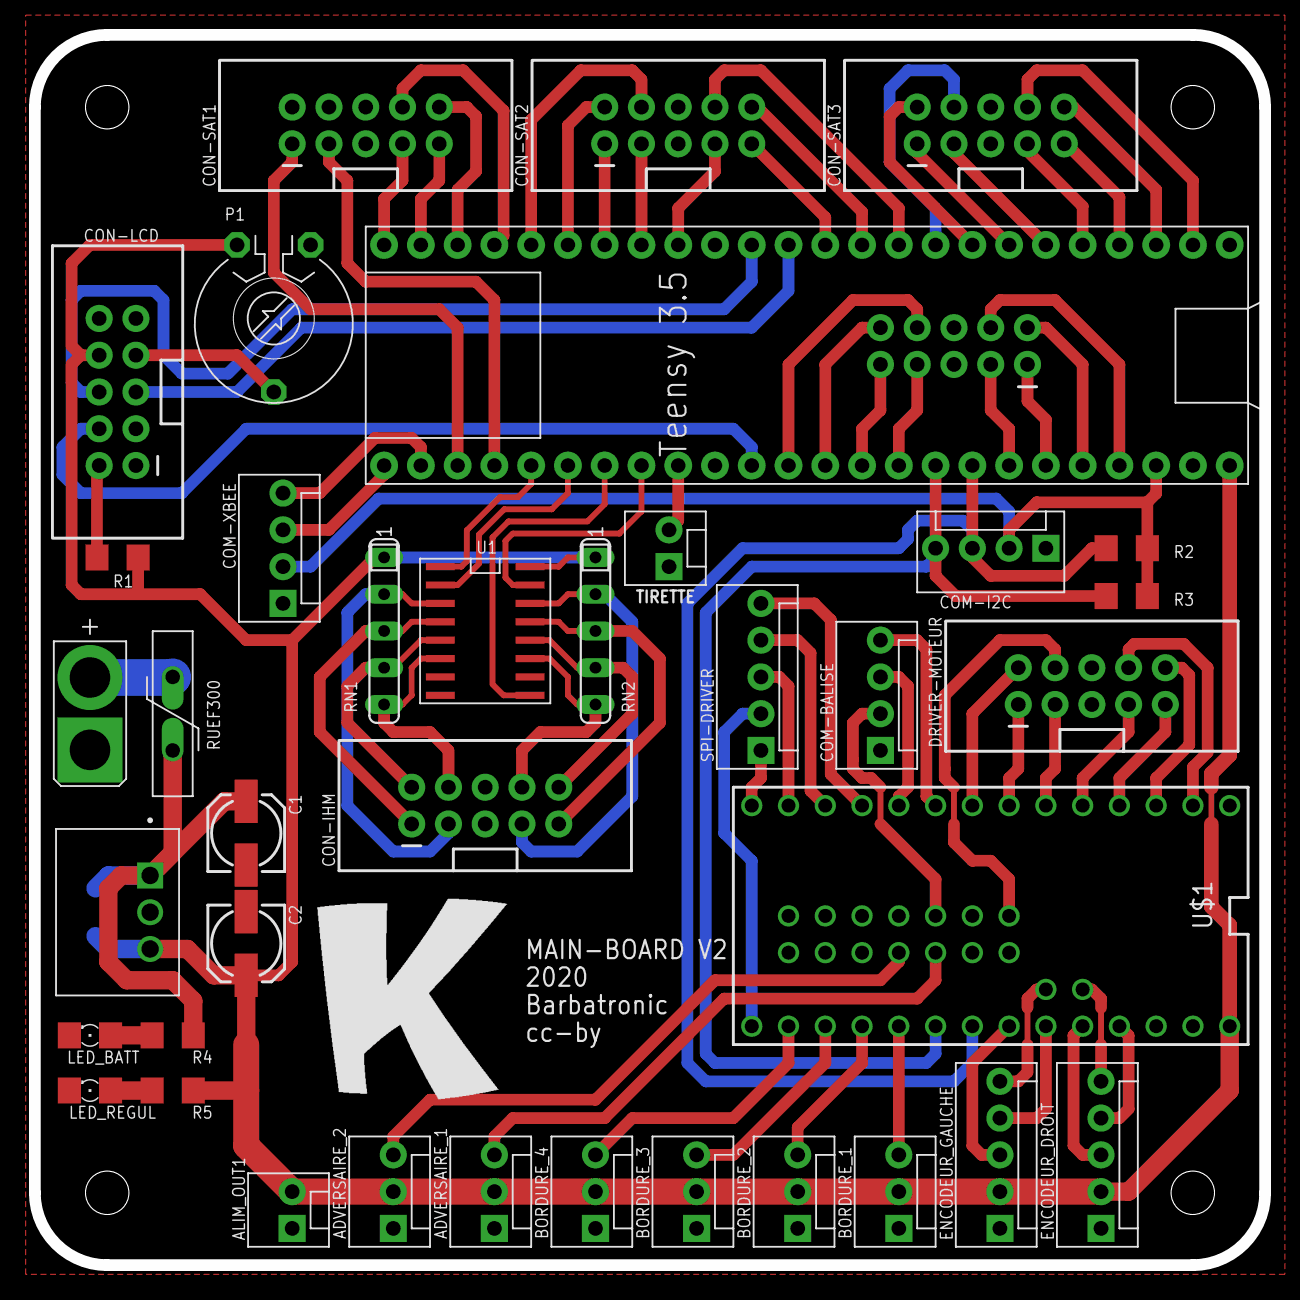
[picture p22: board MAIN_BOARD_02.brd from above]

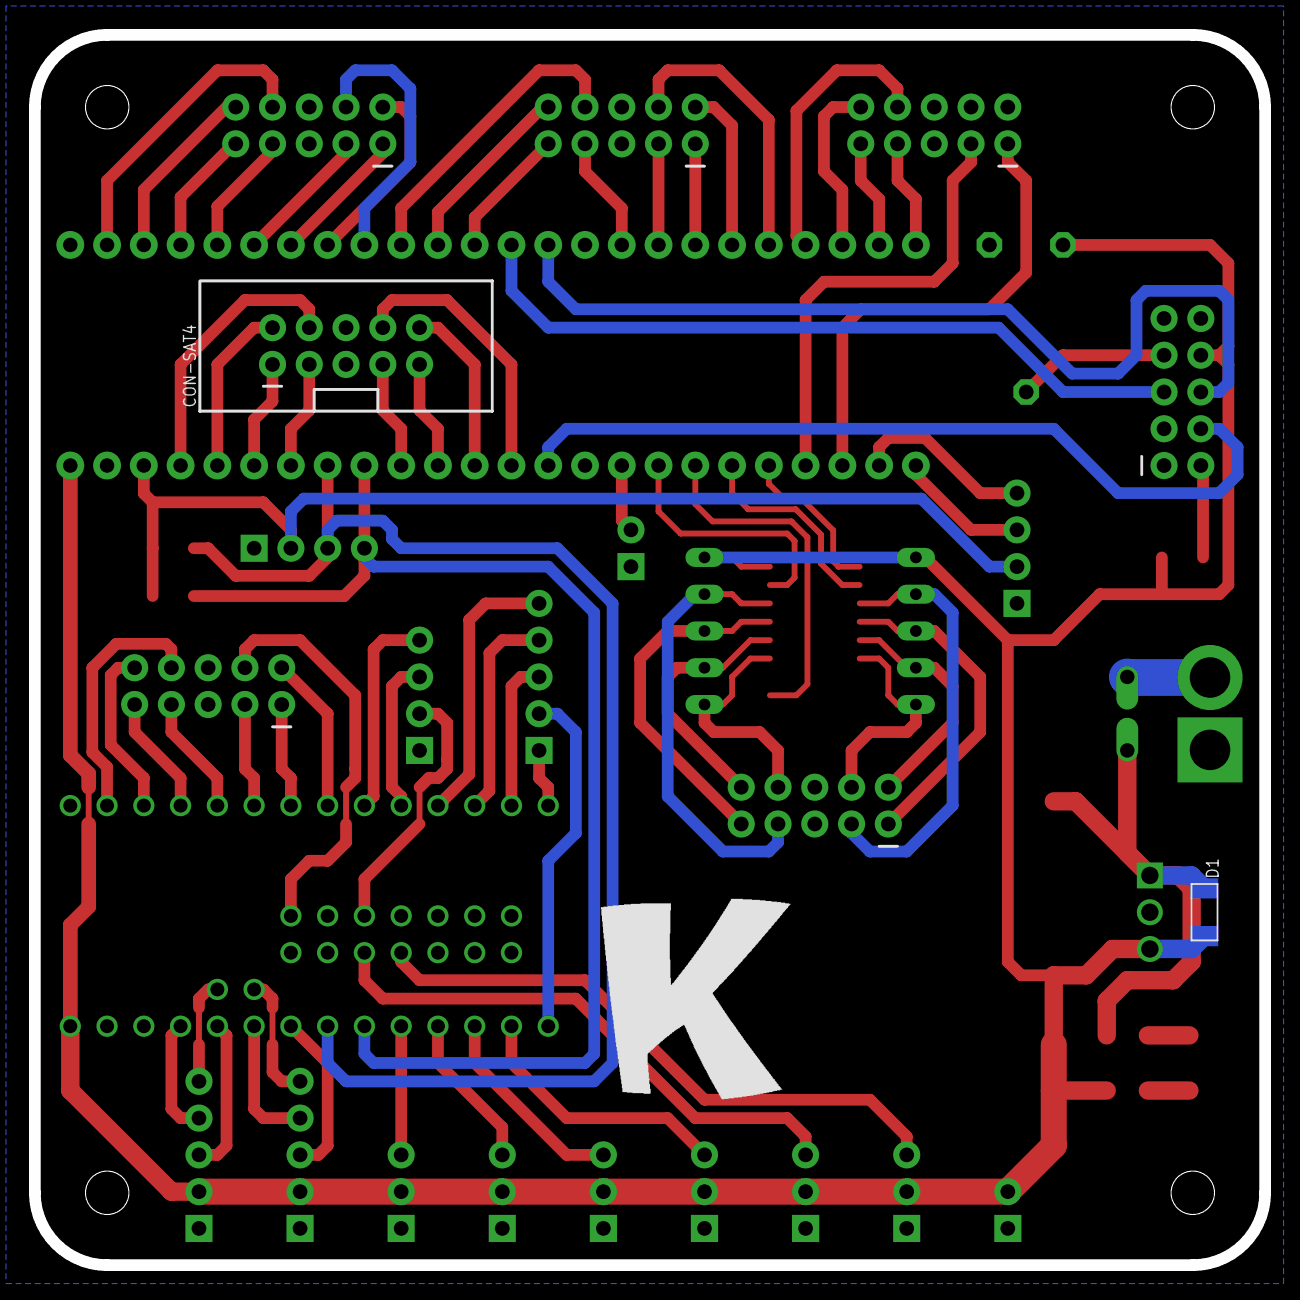
[picture p23: board MAIN_BOARD_02.brd from below]

Board: 2 copper layers, 85.0 x 85.0 mm, 42 parts (3 on the bottom side), 88 nets.
