LesKaribous/Karibous-2020/01 - CDRF/01 - ELECTRONIQUE/CARTE E-STOP/CARTE E-STOP.brd

## EAGLE design 01 - CDRF/01 - ELECTRONIQUE/CARTE E-STOP/CARTE E-STOP.brd (2020-04-24)

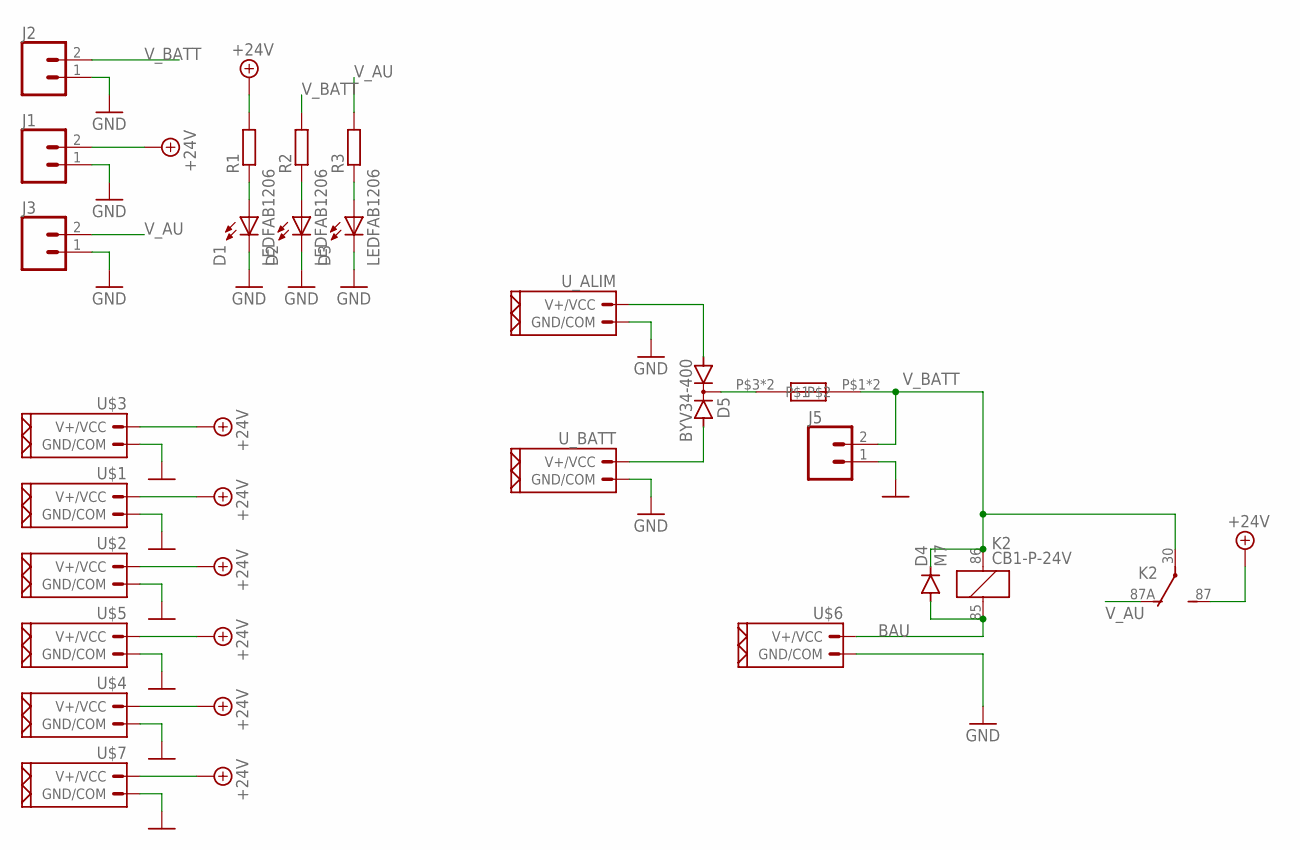
[picture p24: schematic CARTE E-STOP.sch]

Parts:
D1, D2, D3: LEDFAB1206; LED1206FAB
D4: M7; SMA-DO214AC
D5: BYV34-400; TO220ABS
J1, J2, J3, J5: CONN_02POLAR; MOLEX-1X2
K2: CB1-P-24V; CB1
R1, R2, R3: R-EU_M1206; M1206
U$1, U$2, U$3, U$4, U$5, U$7: CONN_02_PUIXT30; XT30_FEMALE
U$6: CONN_02_PUI; NSK396-2C
U$8: AUTOMOTIVE_FUSE3557-2; 3557-2
U_ALIM: CONN_02_PUIXT60; XT60
U_BATT: CONN_02_PUIXT60; XT60

Connections:
+24V: J1.2, K2.87 (S), R1.2, U$1.P$1 (V+/VCC), U$2.P$1 (V+/VCC), U$3.P$1 (V+/VCC), U$4.P$1 (V+/VCC), U$5.P$1 (V+/VCC), U$7.P$1 (V+/VCC)
BAU: D4.A, K2.85 (2), U$6.P$2 (V+/VCC)
GND: D1.2 (C), D2.2 (C), D3.2 (C), J1.1, J2.1, J3.1, J5.1, U$1.P$2 (GND/COM), U$2.P$2 (GND/COM), U$3.P$2 (GND/COM), U$4.P$2 (GND/COM), U$5.P$2 (GND/COM), U$6.P$1 (GND/COM), U$7.P$2 (GND/COM), U_ALIM.P$2 (GND/COM), U_BATT.P$2 (GND/COM)
unnamed: D1.1 (A), R1.1
unnamed: D2.1 (A), R2.1
unnamed: D3.1 (A), R3.1
unnamed: D5.A1, U_ALIM.P$1 (V+/VCC)
unnamed: D5.C, U$8.P$3, U$8.P$4
unnamed: D5.A2, U_BATT.P$1 (V+/VCC)
V_AU: J3.2, K2.87A (O), R3.2
V_BATT: D4.K (C), J2.2, J5.2, K2.30, K2.86 (1), R2.2, U$8.P$1, U$8.P$2
