LesKaribous/Karibous-2020/01 - CDRF/01 - ELECTRONIQUE/CARTE E-STOP/CARTE E-STOP.brd

## EAGLE design 01 - CDRF/01 - ELECTRONIQUE/CARTE E-STOP/CARTE E-STOP.brd (continued)

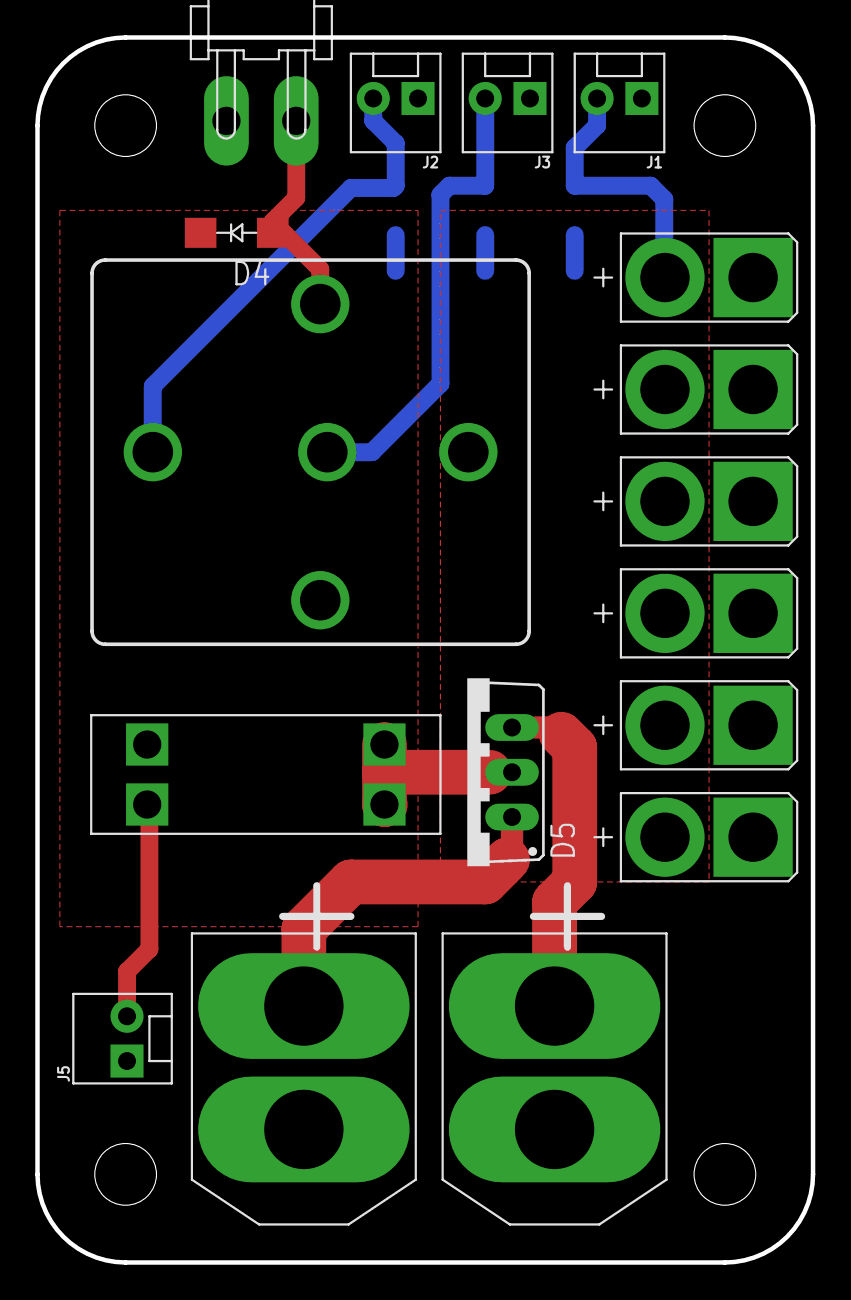
[picture p25: board CARTE E-STOP.brd from above]

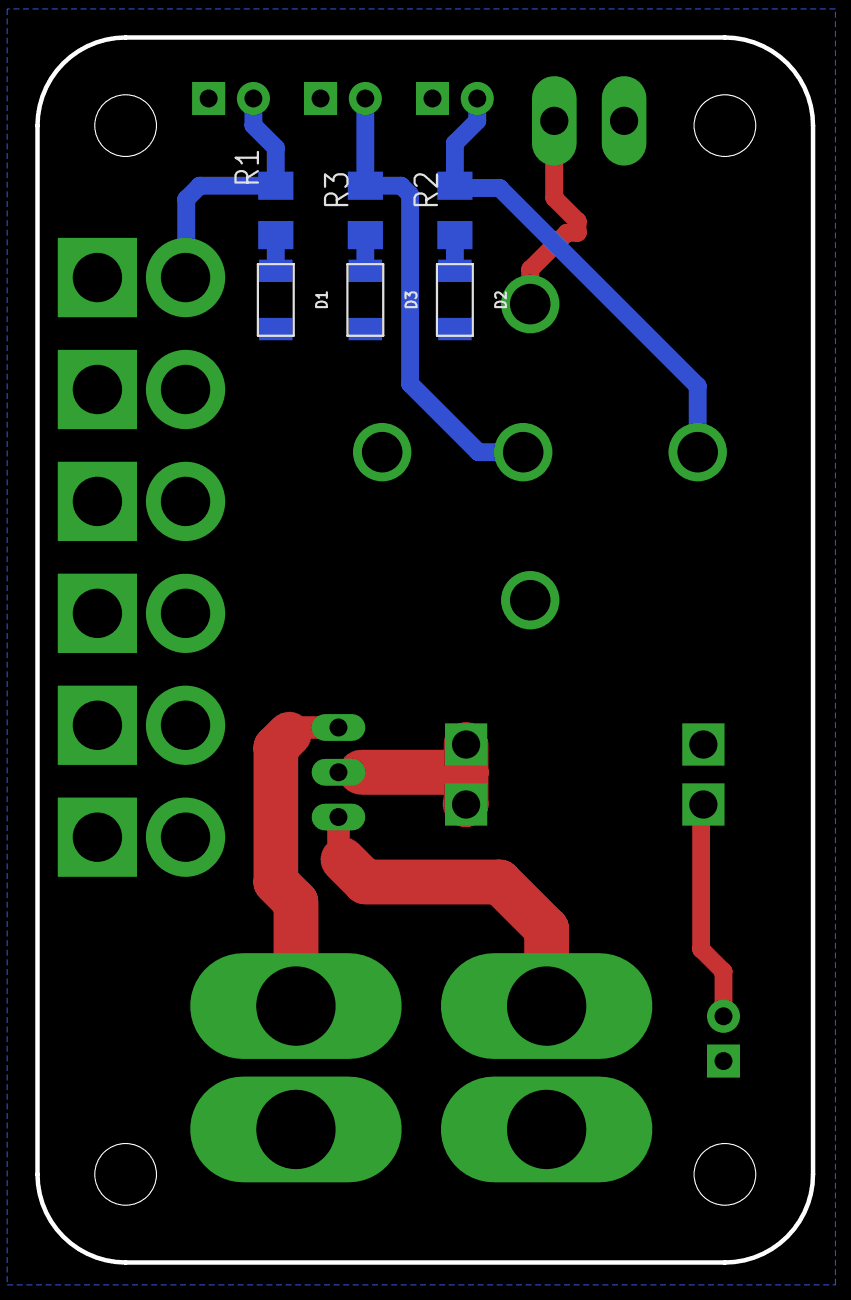
[picture p26: board CARTE E-STOP.brd from below]

Board: 2 copper layers, 44.0 x 69.5 mm, 23 parts (6 on the bottom side), 11 nets.
