LesKaribous/Karibous-2020/01 - CDRF/01 - ELECTRONIQUE/SATELLITE/CARTES SATELLITES/SATELLITE SIMPLE.brd

## EAGLE design 01 - CDRF/01 - ELECTRONIQUE/SATELLITE/CARTES SATELLITES/SATELLITE SIMPLE.brd (2020-04-24)

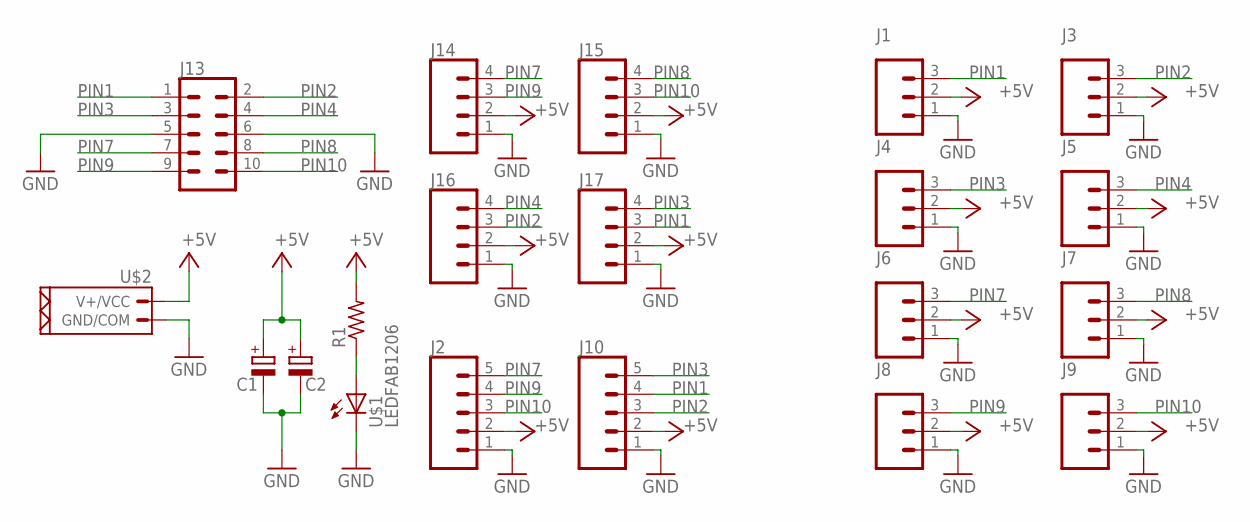
[picture p27: schematic SATELLITE SIMPLE.sch]

Parts:
C1, C2: CPOL-EUE5-10.5; E5-10,5
J1, J3, J4, J5, J6, J7, J8, J9: CONN_03POLAR; MOLEX-1X3
J2, J10: CONN_05; MOLEX-1X5
J13: CONN_05X2SHD; 2X5-SHROUDED
J14, J15, J16, J17: CONN_04POLAR; MOLEX-1X4
R1: RES-US1206FAB; R1206FAB
U$1: LEDFAB1206; LED1206FAB
U$2: CONN_02_PUI; NSK396-2C

Connections:
+5V: C1.+, C2.+, J1.2, J2.2, J3.2, J4.2, J5.2, J6.2, J7.2, J8.2, J9.2, J10.2, J14.2, J15.2, J16.2, J17.2, R1.2, U$2.P$2 (V+/VCC)
GND: C1.-, C2.-, J1.1, J2.1, J3.1, J4.1, J5.1, J6.1, J7.1, J8.1, J9.1, J10.1, J13.5, J13.6, J14.1, J15.1, J16.1, J17.1, U$1.2 (C), U$2.P$1 (GND/COM)
unnamed: R1.1, U$1.1 (A)
PIN1: J1.3, J10.4, J13.1, J17.3
PIN2: J3.3, J10.3, J13.2, J16.3
PIN3: J4.3, J10.5, J13.3, J17.4
PIN4: J5.3, J13.4, J16.4
PIN7: J2.5, J6.3, J13.7, J14.4
PIN8: J7.3, J13.8, J15.4
PIN9: J2.4, J8.3, J13.9, J14.3
PIN10: J2.3, J9.3, J13.10, J15.3

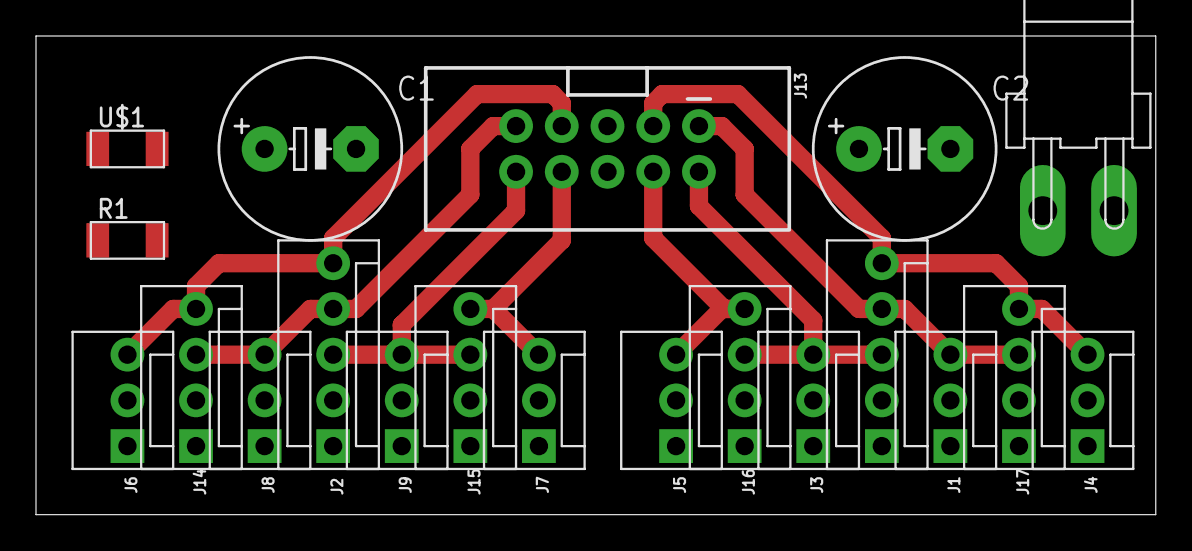
[picture p28: board SATELLITE SIMPLE.brd from above]

Board: 2 copper layers, 62.2 x 26.6 mm, 20 parts (0 on the bottom side), 11 nets.
