LesKaribous/Karibous-2020/01 - CDRF/01 - ELECTRONIQUE/PUMP PCB/PCB PUMP.brd

## EAGLE design 01 - CDRF/01 - ELECTRONIQUE/PUMP PCB/PCB PUMP.brd (2019-10-10)

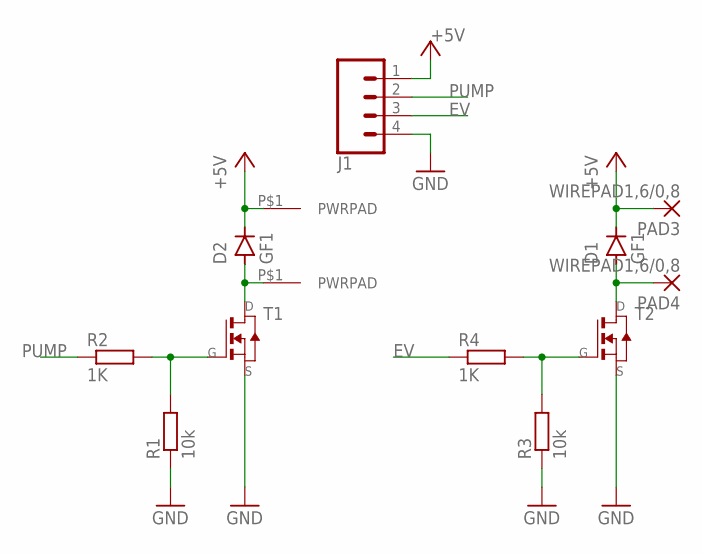
[picture p29: schematic PCB PUMP.sch]

Parts:
D1, D2: GF1; SMA-DO214AC
J1: CONN_04POLAR; MOLEX-1X4
J3, J4: PWRPAD2-5MM; PWRPAD_2-5MM
PAD3, PAD4: WIREPAD1,6/0,8; 1,6/0,8
R1, R3: 10k; R1206
R2, R4: 1K; R1206
T1, T2: NMOSFETSOT23; SOT-23

Connections:
+5V: D1.K (C), D2.K (C), J1.1, J4.P$1, PAD3.1
EV: J1.3, R4.1
GND: J1.4, R1.1, R3.1, T1.2 (S), T2.2 (S)
unnamed: D1.A, PAD4.1, T2.1 (D)
unnamed: D2.A, J3.P$1, T1.1 (D)
unnamed: R1.2, R2.2, T1.3 (G)
unnamed: R3.2, R4.2, T2.3 (G)
PUMP: J1.2, R2.1

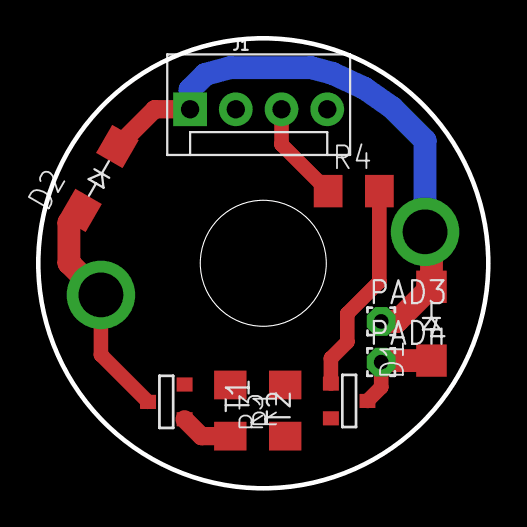
[picture p30: board PCB PUMP.brd from above]

Board: 2 copper layers, 25.0 x 25.0 mm, 13 parts (1 on the bottom side), 8 nets.
