LesKaribous/Karibous-2020/01 - CDRF/01 - ELECTRONIQUE/PCB MAT BALISE/PCB MAT BALISE/PCB_MAT_BALISE.brd

## EAGLE design 01 - CDRF/01 - ELECTRONIQUE/PCB MAT BALISE/PCB MAT BALISE/PCB_MAT_BALISE.brd (2019-10-25)

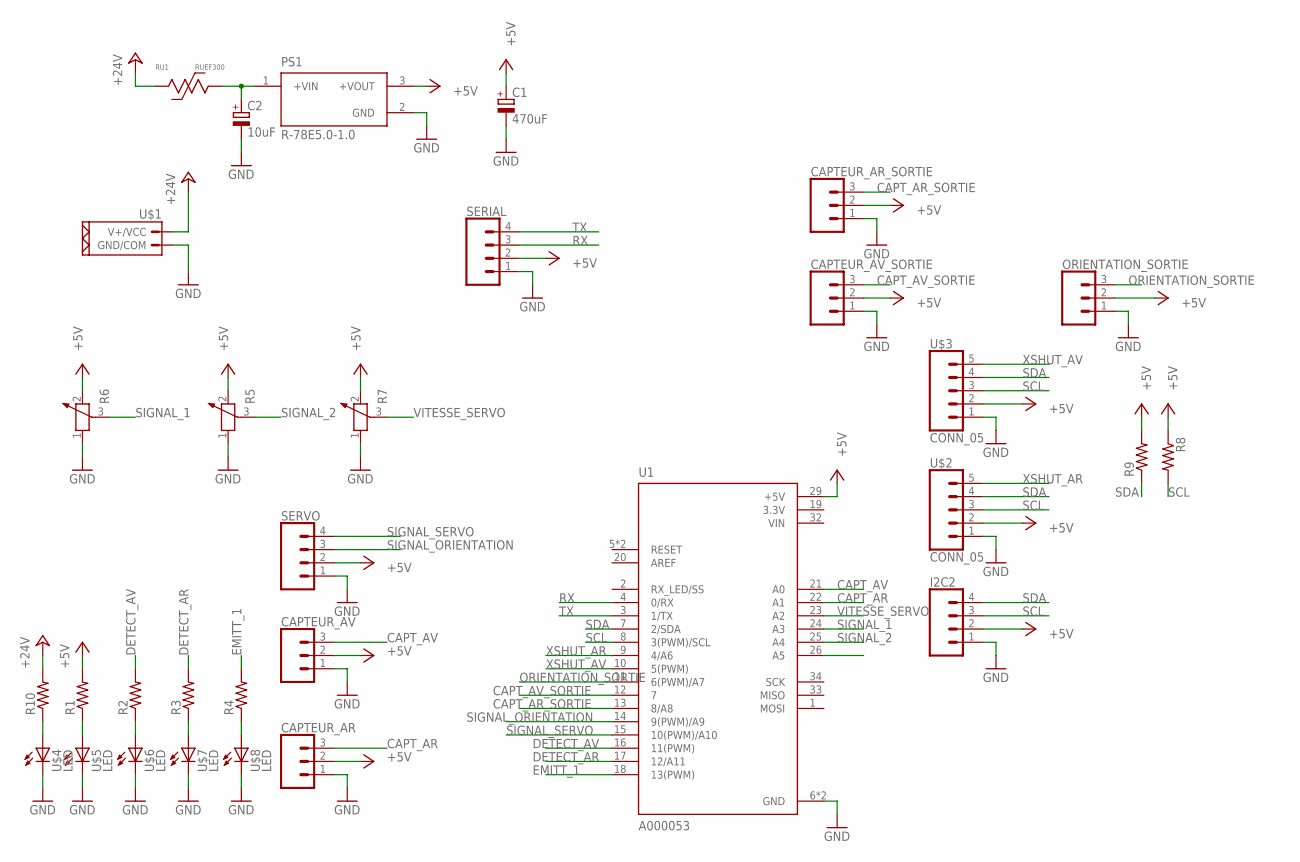
[picture p31: schematic PCB_MAT_BALISE.sch]

Parts:
C1: 470uF; E5-10,5
C2: 10uF; E2,5-7
CAPTEUR_AR: CONN_03POLAR; MOLEX-1X3
CAPTEUR_AR_SORTIE: CONN_03POLAR; MOLEX-1X3
CAPTEUR_AV: CONN_03POLAR; MOLEX-1X3
CAPTEUR_AV_SORTIE: CONN_03POLAR; MOLEX-1X3
I2C2: CONN_04POLAR; MOLEX-1X4
ORIENTATION_SORTIE: CONN_03POLAR; MOLEX-1X3
PS1: R-78E5.0-1.0; CONV_R-78E5.0-1.0
R1, R2, R3, R4, R8, R9, R10: RES-US1206FAB; R1206FAB
R5, R6, R7: POTENTIOMETER_PT-10; PT-10
RU1: RUEF300
SERIAL: CONN_04POLAR; MOLEX-1X4
SERVO: CONN_04POLAR; MOLEX-1X4
U1: A000053; ARDUINO_A000053
U$1: CONN_02_PUI; NSK396-2C
U$2, U$3: CONN_05; MOLEX-1X5
U$4, U$5, U$6, U$7, U$8: LED; LED1206

Connections:
3.3V: U1.19 (3.3V)
+5V: C1.+, CAPTEUR_AR.2, CAPTEUR_AR_SORTIE.2, CAPTEUR_AV.2, CAPTEUR_AV_SORTIE.2, I2C2.2, ORIENTATION_SORTIE.2, PS1.3 (+VOUT), R1.2, R5.2, R6.2, R7.2, R8.1, R9.2, SERIAL.2, SERVO.2, U1.29 (+5V), U$2.2, U$3.2
+24V: R10.2, RU1.P$1, U$1.P$2 (V+/VCC)
CAPT_AR: CAPTEUR_AR.3, U1.22 (A1)
CAPT_AR_SORTIE: CAPTEUR_AR_SORTIE.3, U1.13 (8/A8)
CAPT_AV: CAPTEUR_AV.3, U1.21 (A0)
CAPT_AV_SORTIE: CAPTEUR_AV_SORTIE.3, U1.12 (7)
DETECT_AR: R3.2, U1.17 (12/A11)
DETECT_AV: R2.2, U1.16 (11(PWM))
EMITT_1: R4.2, U1.18 (13(PWM))
GND: C1.-, C2.-, CAPTEUR_AR.1, CAPTEUR_AR_SORTIE.1, CAPTEUR_AV.1, CAPTEUR_AV_SORTIE.1, I2C2.1, ORIENTATION_SORTIE.1, PS1.2 (GND), R5.1, R6.1, R7.1, SERIAL.1, SERVO.1, U1.6 (GND), U1.31 (GND), U$1.P$1 (GND/COM), U$2.1, U$3.1, U$4.2 (C), U$5.2 (C), U$6.2 (C), U$7.2 (C), U$8.2 (C)
unnamed: R1.1, U$5.1 (A)
unnamed: R2.1, U$6.1 (A)
unnamed: R3.1, U$7.1 (A)
unnamed: R4.1, U$8.1 (A)
unnamed: C2.+, PS1.1 (+VIN), RU1.P$2
unnamed: R10.1, U$4.1 (A)
ORIENTATION_SORTIE: ORIENTATION_SORTIE.3, U1.11 (6(PWM)/A7)
RX: SERIAL.3, U1.4 (0/RX)
SCL: I2C2.3, R8.2, U1.8 (3(PWM)/SCL), U$2.3, U$3.3
SDA: I2C2.4, R9.1, U1.7 (2/SDA), U$2.4, U$3.4
SIGNAL_1: R6.3, U1.24 (A3)
SIGNAL_2: R5.3, U1.25 (A4)
SIGNAL_ORIENTATION: SERVO.3, U1.14 (9(PWM)/A9)
SIGNAL_SERVO: SERVO.4, U1.15 (10(PWM)/A10)
TX: SERIAL.4, U1.3 (1/TX)
VIN: U1.32 (VIN)
VITESSE_SERVO: R7.3, U1.23 (A2)
XSHUT_AR: U1.9 (4/A6), U$2.5
XSHUT_AV: U1.10 (5(PWM)), U$3.5

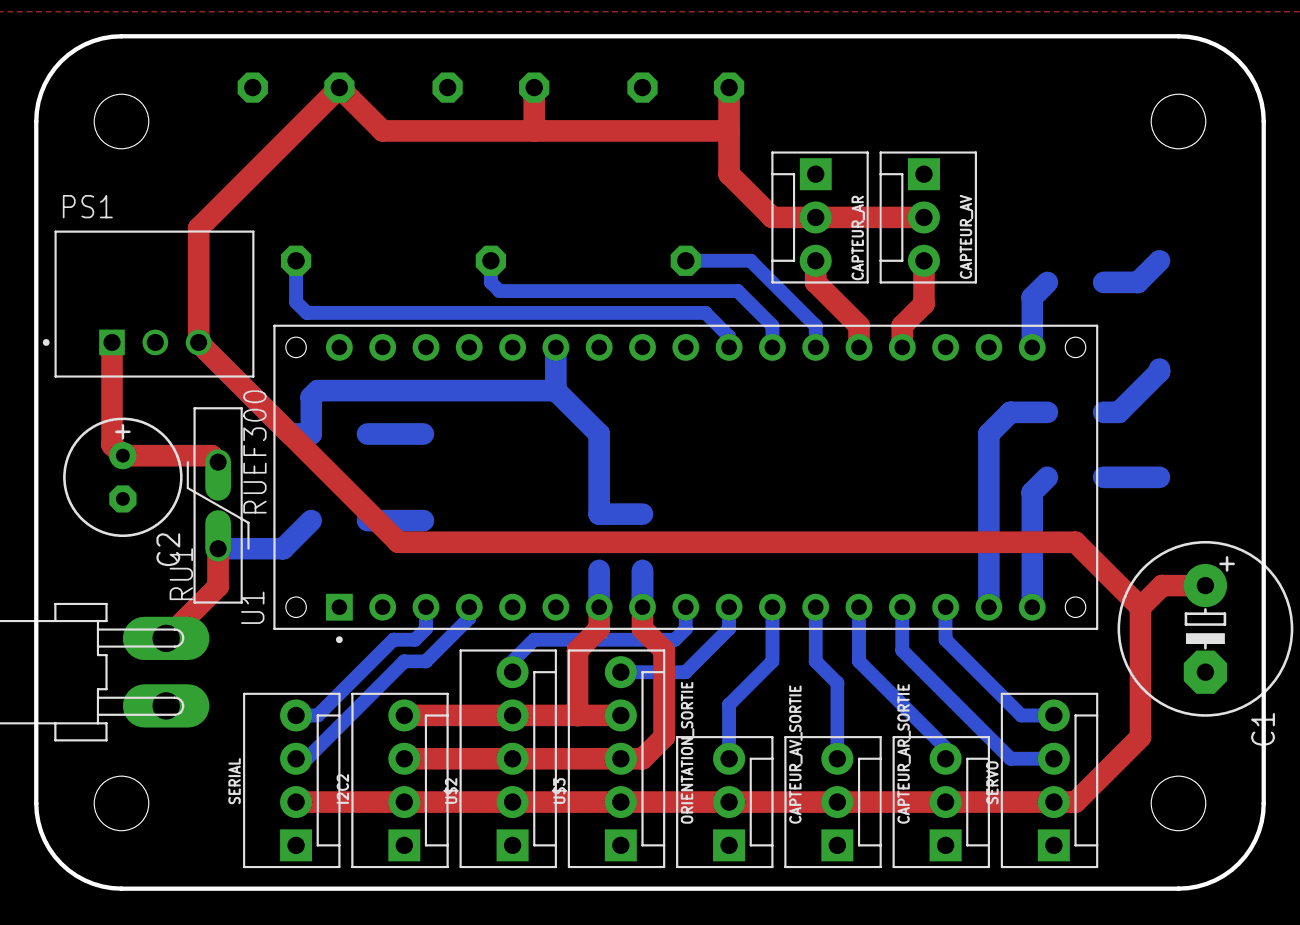
[picture p32: board PCB_MAT_BALISE.brd from above]

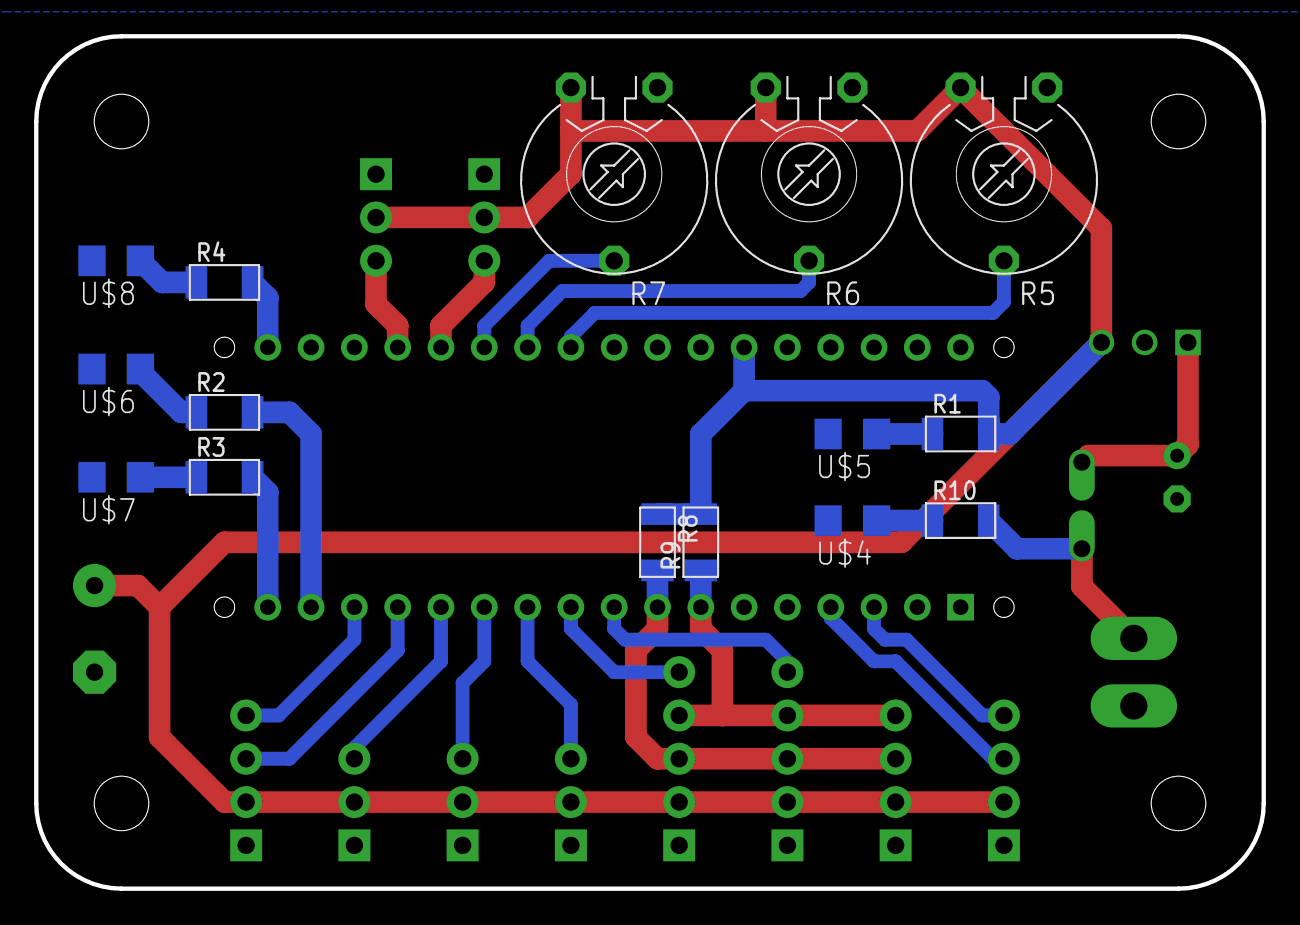
[picture p33: board PCB_MAT_BALISE.brd from below]

Board: 2 copper layers, 72.0 x 50.0 mm, 31 parts (15 on the bottom side), 28 nets.
