LesKaribous/Karibous-2020/01 - CDRF/01 - ELECTRONIQUE/PUMP PCB/PCB PUMP LED SENSOR.brd

## EAGLE design 01 - CDRF/01 - ELECTRONIQUE/PUMP PCB/PCB PUMP LED SENSOR.brd (2020-01-19)

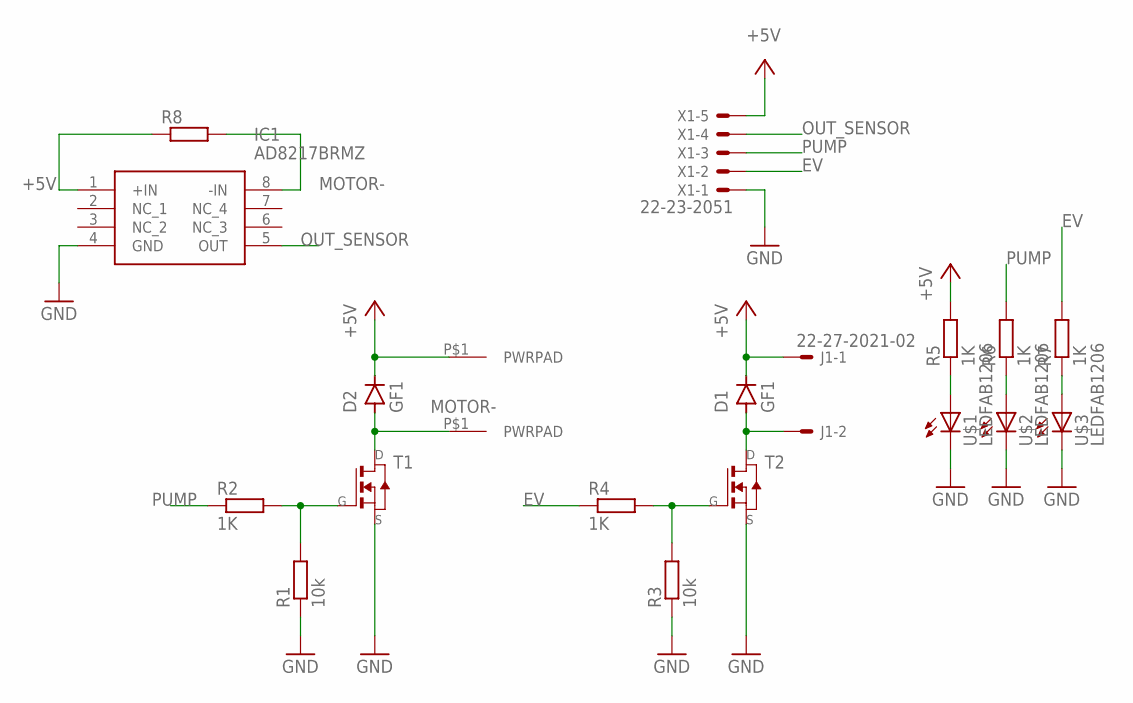
[picture p34: schematic PCB PUMP LED SENSOR.sch]

Parts:
D1, D2: GF1; SMA-DO214AC
IC1: AD8217BRMZ; SOP65P490X110-8N
J1: 22-27-2021-02; 6410-02
J3, J4: PWRPAD2-5MM; PWRPAD_2-5MM
R1, R3: 10k; R1206
R2, R4, R5, R6, R7: 1K; R1206
R8: R-EU_R0805; R0805
T1, T2: NMOSFETSOT23; SOT-23
U$1, U$2, U$3: LEDFAB1206; LED1206FAB
X1: 22-23-2051

Connections:
+5V: D1.K (C), D2.K (C), IC1.1 (+IN), J1.1, J4.P$1, R5.2, R8.1, X1.5
EV: R4.1, R7.2, X1.2
GND: IC1.4 (GND), R1.1, R3.1, T1.2 (S), T2.2 (S), U$1.2 (C), U$2.2 (C), U$3.2 (C), X1.1
MOTOR-: D2.A, IC1.8 (-IN), J3.P$1, R8.2, T1.1 (D)
unnamed: D1.A, J1.2, T2.1 (D)
unnamed: R1.2, R2.2, T1.3 (G)
unnamed: R3.2, R4.2, T2.3 (G)
unnamed: R5.1, U$1.1 (A)
unnamed: R6.1, U$2.1 (A)
unnamed: R7.1, U$3.1 (A)
OUT_SENSOR: IC1.5 (OUT), X1.4
PUMP: R2.1, R6.2, X1.3

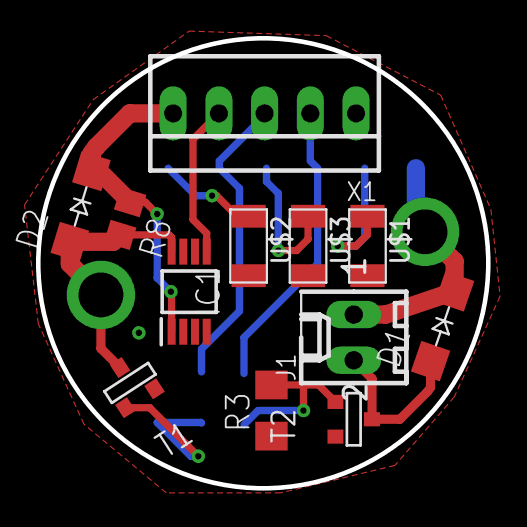
[picture p35: board PCB PUMP LED SENSOR.brd from above]

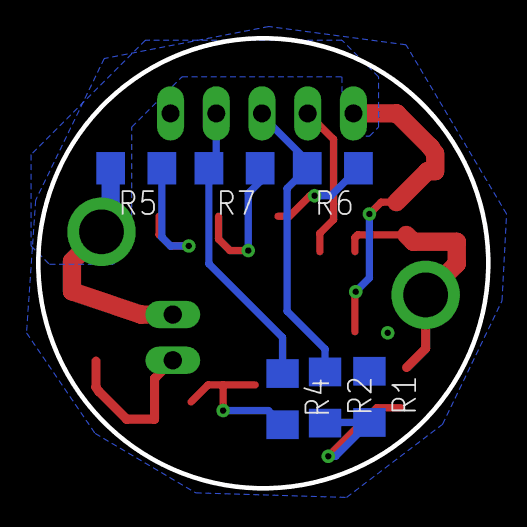
[picture p36: board PCB PUMP LED SENSOR.brd from below]

Board: 2 copper layers, 25.0 x 25.0 mm, 20 parts (6 on the bottom side), 12 nets.
