LesKaribous/Karibous-2020/02 - MAKERFIGHT/02 - ELECTRONIQUE/CARTE_PUISSANCE/CARTE_PUISSANCE.brd

## EAGLE design 02 - MAKERFIGHT/02 - ELECTRONIQUE/CARTE_PUISSANCE/CARTE_PUISSANCE.brd (2020-01-28)

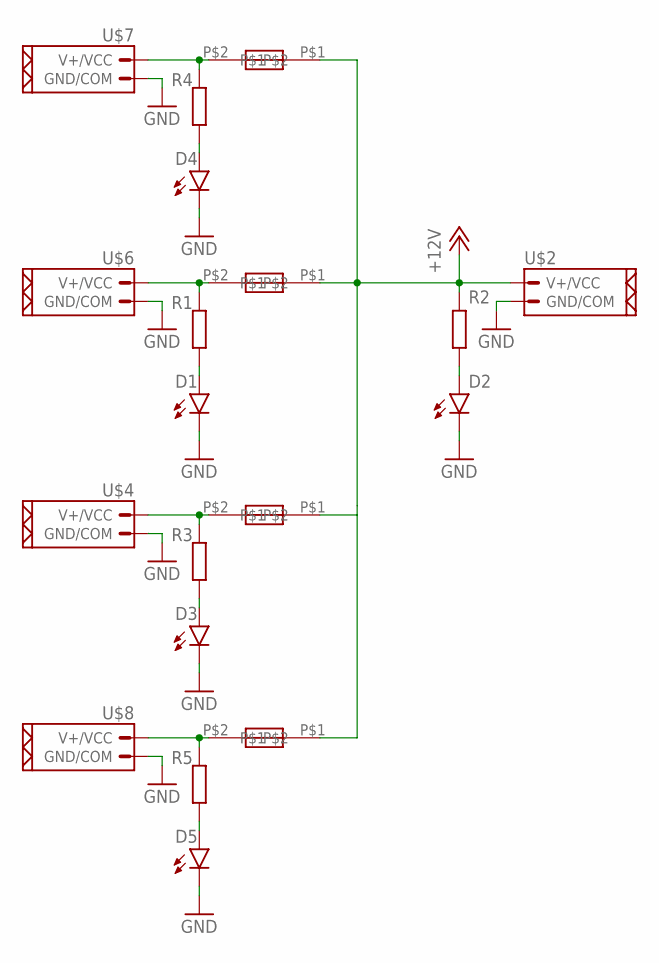
[picture p37: schematic CARTE_PUISSANCE.sch]

Parts:
D1, D2, D3, D4, D5: LED5MM; LED_5MM
R1, R2, R3, R4, R5: R-EU_0204/7; 0204/7
U$1, U$3, U$5, U$9: AUTOMOTIVE_FUSE
U$2, U$4, U$6, U$7, U$8: CONN_02_PUIXT60; XT60

Connections:
+12V: R2.2, U$1.P$1, U$2.P$1 (V+/VCC), U$3.P$1, U$5.P$1, U$9.P$1
GND: D1.K (C), D2.K (C), D3.K (C), D4.K (C), D5.K (C), U$2.P$2 (GND/COM), U$4.P$2 (GND/COM), U$6.P$2 (GND/COM), U$7.P$2 (GND/COM), U$8.P$2 (GND/COM)
unnamed: R1.2, U$3.P$2, U$6.P$1 (V+/VCC)
unnamed: D1.A, R1.1
unnamed: R5.2, U$8.P$1 (V+/VCC), U$9.P$2
unnamed: D2.A, R2.1
unnamed: R3.2, U$4.P$1 (V+/VCC), U$5.P$2
unnamed: D3.A, R3.1
unnamed: R4.2, U$1.P$2, U$7.P$1 (V+/VCC)
unnamed: D4.A, R4.1
unnamed: D5.A, R5.1

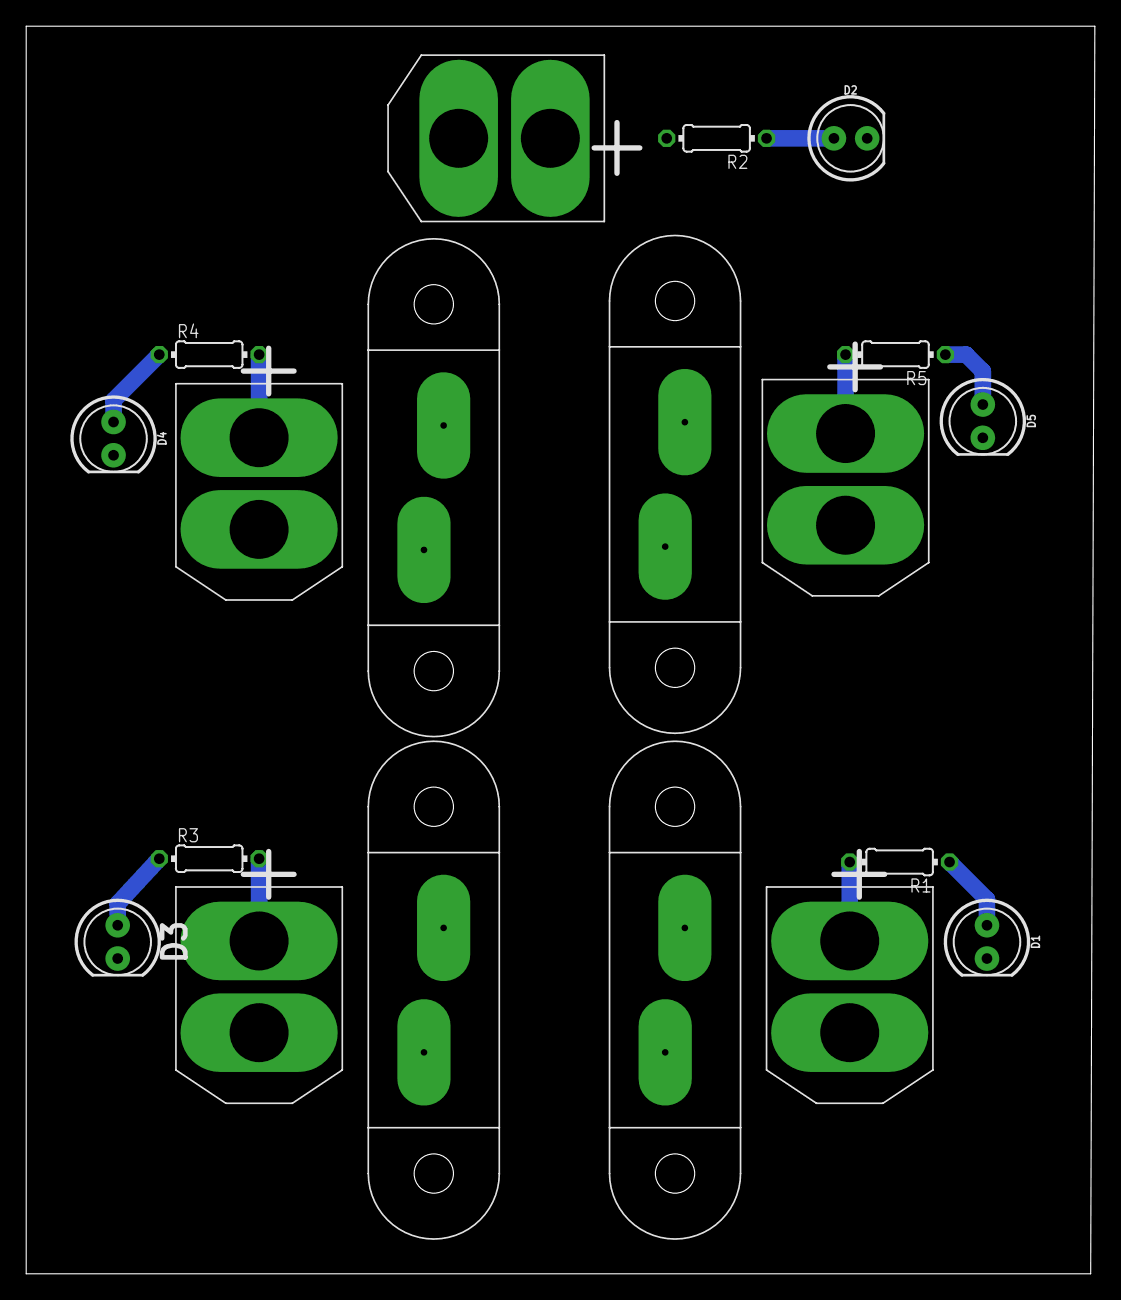
[picture p38: board CARTE_PUISSANCE.brd from above]

Board: 2 copper layers, 81.6 x 95.2 mm, 19 parts (0 on the bottom side), 11 nets.
