LesKaribous/Karibous-2020/01 - CDRF/04 - SOFTWARE/INTERFACE_ROBOT/INTERFACE_ROBOT.pde

import controlP5.*;                  // Import the CP5 library
import processing.serial.*;          // Import the serial library

Serial myPort;                       // Create the serial port object
ControlP5 cp5;                       // Create the CP5 object

PImage img;

// Creation of the variable for the GUI
// Console
Textarea consoleArea;
Println console;
// Creation of the lists
ScrollableList serialList;
// Creation of the buttons
Button serialBegin;
Button buttonEnvoyer;
Button serialStop;
Button serialRefresh;
// State of the buttons
boolean clicSerialBegin = false ;
boolean clicSerialStop = false ;
boolean clicSerialSend = false ;
boolean clicSerialRefresh = false ;
// Creation of the sliders
Slider heightSliderLeft;
Slider heightSliderRight;
// Creation of the toggles
Toggle togglePumpLeft;
Toggle togglePumpRight;
Toggle toggleValveLeft;
Toggle toggleValveRight;

Toggle toggleDirectSend;

Button resetTurn;
Button resetGo;

Button flecheAvant;
Button flecheArriere;
Button flecheGauche;
Button flecheDroite;

Textlabel labelDirectSend;

Textfield textKnobServoLeft;
Textfield textKnobServoRight;
Textfield textKnobPoignetLeft;
Textfield textKnobPoignetRight;

Textfield textSliderLeft;
Textfield textSliderRight;

Textfield textTurnParameter;
Textfield textGoParameter;

// Creation of the knobs
Knob knobServoRight;
Knob knobServoLeft;
Knob knobMiniServoRight;
Knob knobMiniServoLeft;

Tab tabBras;
Tab tabExtra;
Tab tabDeplacement;

color blackFont = color(20,20,20);
color blue = color(0,0,100);
color baseGreen = color(0,80,0);
color clearGreen = color(0,200,0);
color selectGreen = color(0,250,0);
// State of the toggles
boolean toggleValue = false;
// GUI Visibility
boolean GUIVisible = true;
// State new message
boolean newPosition = false;

int guiDecalageBrasX = 120;
int guiPaddingBrasX= 40;
int guiPaddingBrasY= 40;


// Communication variables
byte[] receivedBuf = new byte[14];
int[] transformBuf = new int[4];
byte[] sendBuf = new byte[16];

int distance, angle;


void setup()
{
  size(250,750);
  frameRate(24);
  noStroke();
  fill(0);

  createGUI();
}

void draw()
{
  background(255);
  tint(255,255,255,80);
  image(img, 25, 250, 200, 200);
}

void serialEvent(Serial p)
{
  p.readBytesUntil(10,receivedBuf);
  p.clear();
  if(receivedBuf[0]=='b')
  {
    print("Raw datas : ");
    for(int i=0;i<=5;i++)
    {
      print(receivedBuf[i] + " ");
    }
    println();

    for(int i =0;i<=3;i++)
       {
         transformBuf[i] = unsignedByte(receivedBuf[i+1]);
       }
    distance = transformBuf[0] << 8 | transformBuf[1];
    angle = transformBuf[2] << 8 | transformBuf[3];
    print(distance);
    print(" ; ");
    println(angle);
    newPosition = true;
  }
  else
  {
    println("Serial corruption - informations ignored");
    newPosition = false;
  }
}

// Convert a signed Byte ( 127 to - 128 ) to an Int between 0 and 255
int unsignedByte(byte value)
{
  if(value < 0) return value + 256 ;
  else return value;
}
