LesKaribous/Karibous-2020/(commit log)

2019-10-06 first version
    [PCB PUMP.brd, PCB PUMP.sch]
2019-10-06 PCB - update
2019-10-07 Update
    Change P-MOSFET by N-MOSFET
    [PCB PUMP.brd, PCB PUMP.sch]
2019-10-10 Create PCB PUMP_2019-10-10.zip
2019-10-10 update 3D packages
    [PCB PUMP LED.brd, PCB PUMP LED.sch]
2019-10-10 Update PCB PUMP LED.brd
    [PCB PUMP LED.brd]
2020-01-19 update pcb pump
    [PCB PUMP LED SENSOR.brd, PCB PUMP LED SENSOR.sch]
2020-01-31 first update
    [CLAMP.stl, CONNECTEUR_T.stl]
2020-02-10 update name
    [CLAMP.stl, CONNECTEUR_T.stl, EQUERRE CARTER ELEC.stl, MAT BALISE Drawing.dxf, PCB PUMP LED SENSOR.brd, PCB PUMP LED SENSOR.sch, PCB PUMP LED.brd, PCB PUMP LED.sch]
2020-02-10 Archive 2019
    Archive 2019 pour faire les essais du code 2020
2020-03-07 Class BRAS
    [MANCHONE_COUDE.stl, MORS.stl]
2020-03-07 Clean up
    [MANCHONE_COUDE.stl, MORS.stl]
2020-03-07 add servo drapeau
2020-04-24 :sparkles: new
    [CARTE E-STOP.brd, CARTE E-STOP.sch, SATELLITE SIMPLE.brd, SATELLITE SIMPLE.sch]
2020-05-01 Com de la fonction attente | Attente planner
2020-05-18 update pcb
    [AdaptSensor.brd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]
2020-06-22 update elec
    [AdaptSensor.brd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]
2020-06-26 electrical update
    [PCB_BALISE_328P.brd, PCB_BALISE_328P.sch]
