LesKaribous/Karibous-2020/(notices)

Notices in the files:
01 - CDRF/01 - ELECTRONIQUE/MAIN_BOARD V2/MAIN_BOARD_02.brd:
cc-by
